Kr3jzolPL/longboi/schematics/longboi-v1.1-schematics.pdf

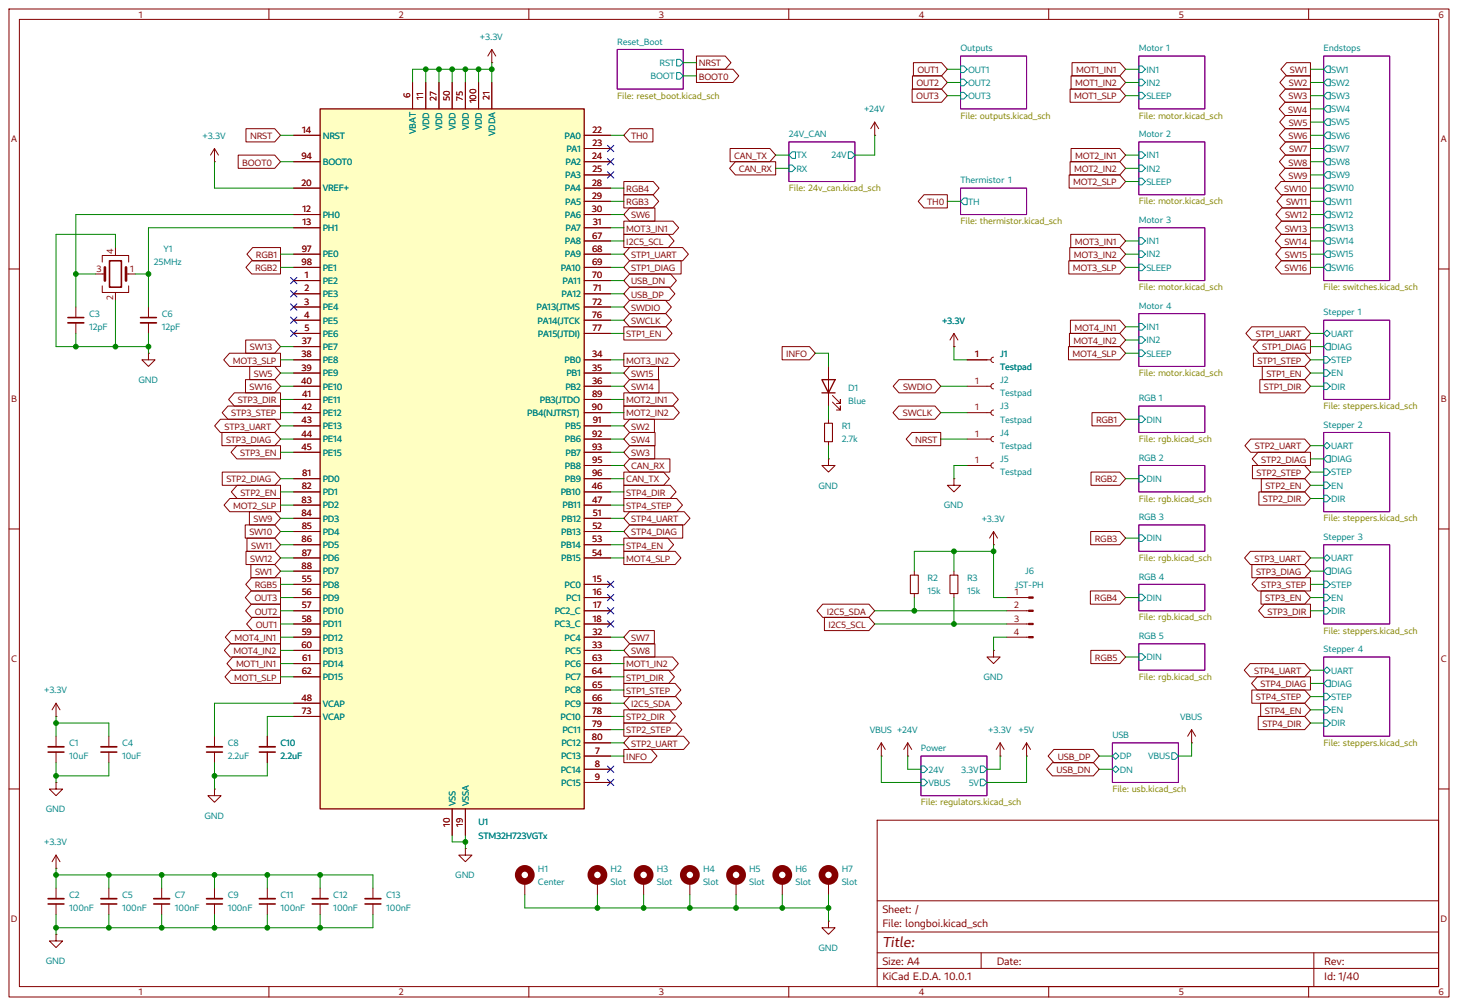
[picture p1: page 1]

IN2 SLEEP Motor 1 File: motor.kicad_sch

IN2 SLEEP Motor 3 File: motor.kicad_sch R2

Stepper 1 File: steppers.kicad_sch UART DIAG

RGB 1 File: rgb.kicad_sch DIN

Stepper 2 File: steppers.kicad_sch DIN

File: rgb.kicad_sch DIN
RGB 5 File: rgb.kicad_sch VBUS DN

VBUS Power File: regulators.kicad_sch

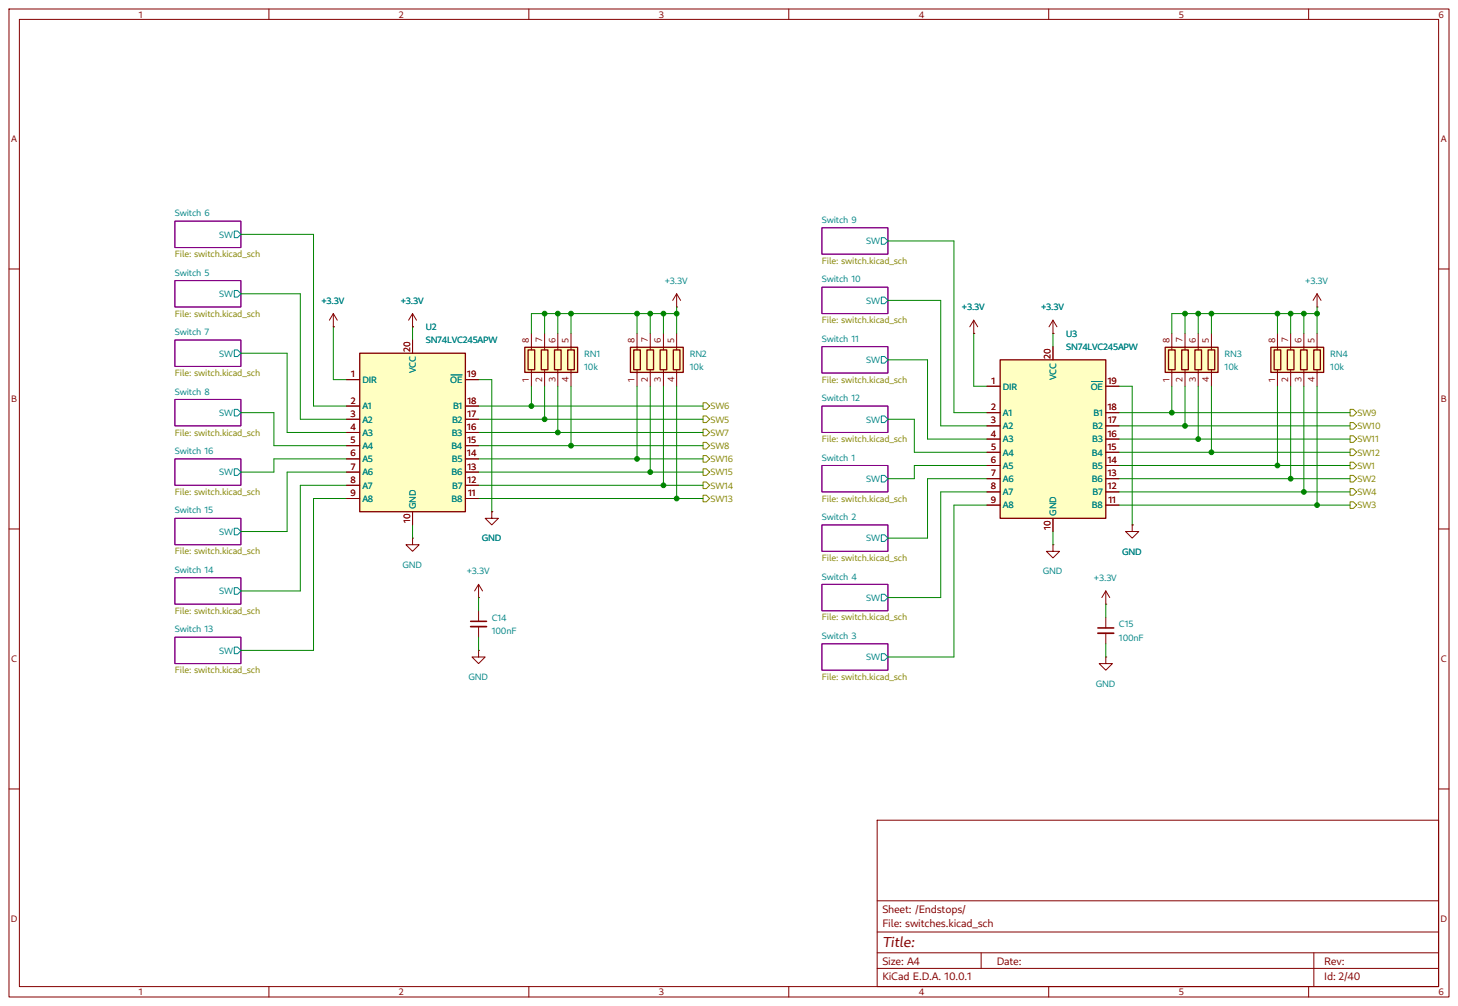
[picture p2: page 2]

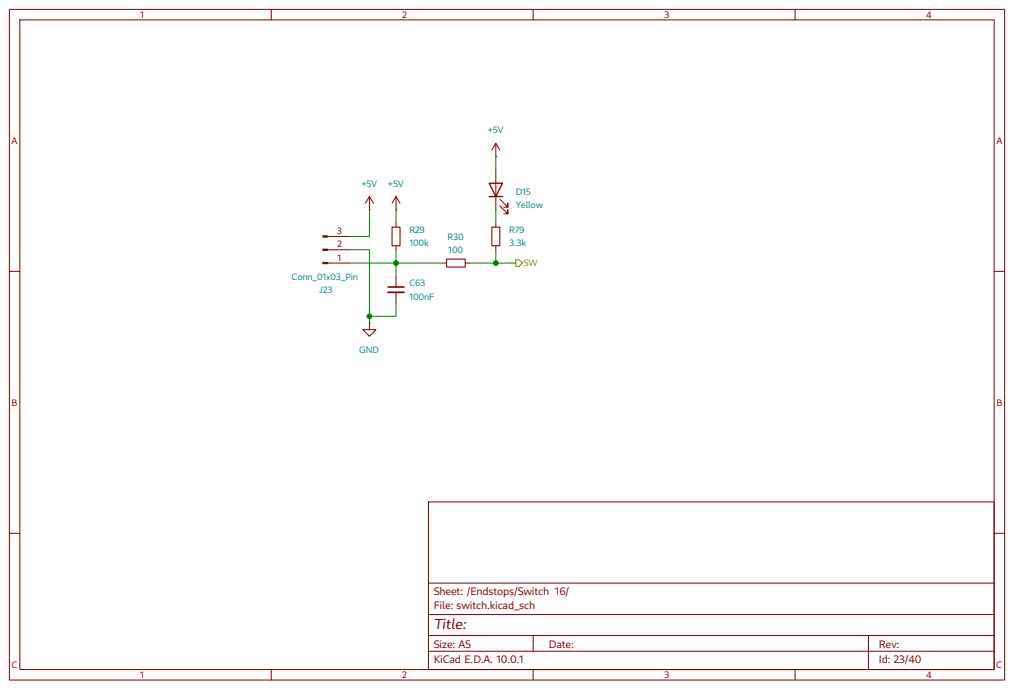
[picture p3: page 3]

Size: A5 | Date: | Rev:
KiCad E.D.A. 10.0.1 | | Id: 23/40

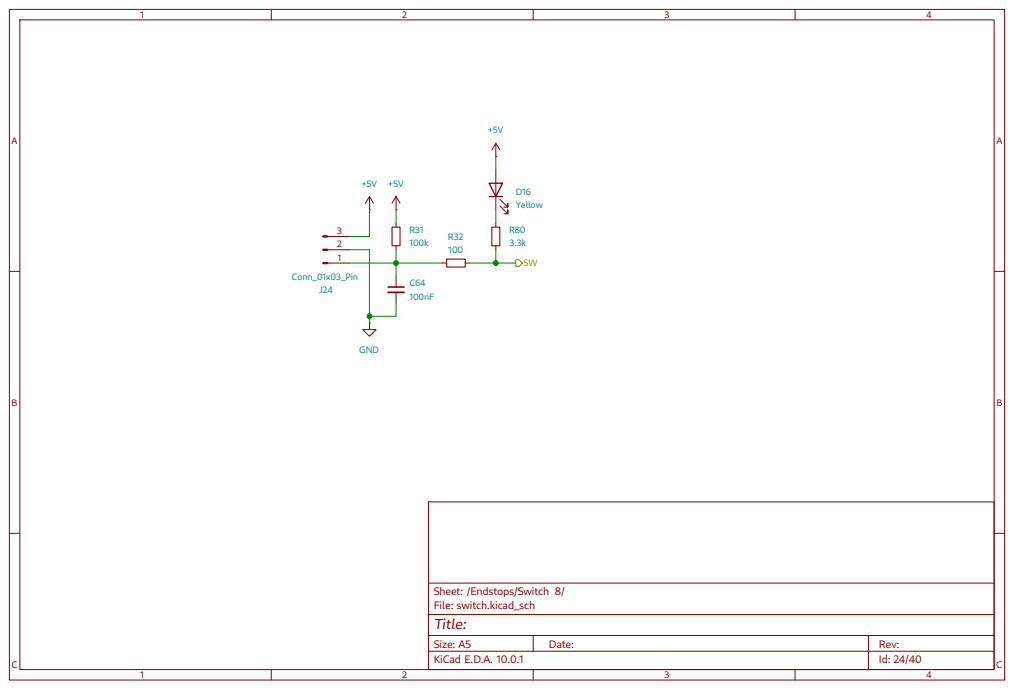
[picture p4: page 4]

Size: A5 | Date: | Rev:
KiCad E.D.A. 10.0.1 | | Id: 24/40

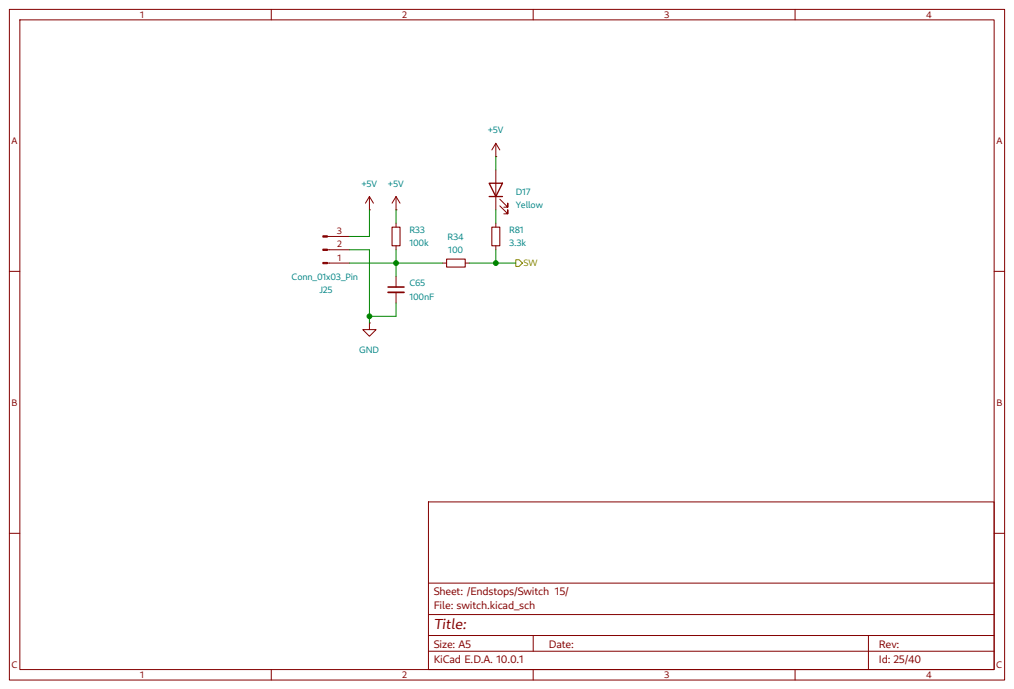
[picture p5: page 5]

Size: A5 | Date: | Rev:
KiCad E.D.A. 10.0.1 | | Id: 25/40

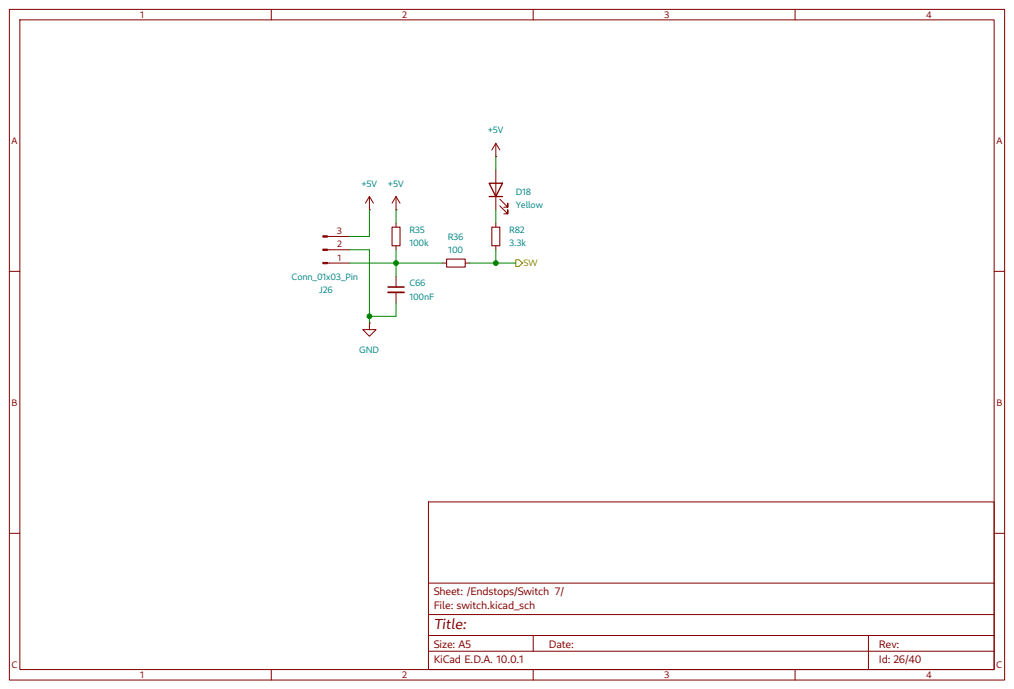
[picture p6: page 6]

Size: A5 | Date: | Rev:
KiCad E.D.A. 10.0.1 | | Id: 26/40

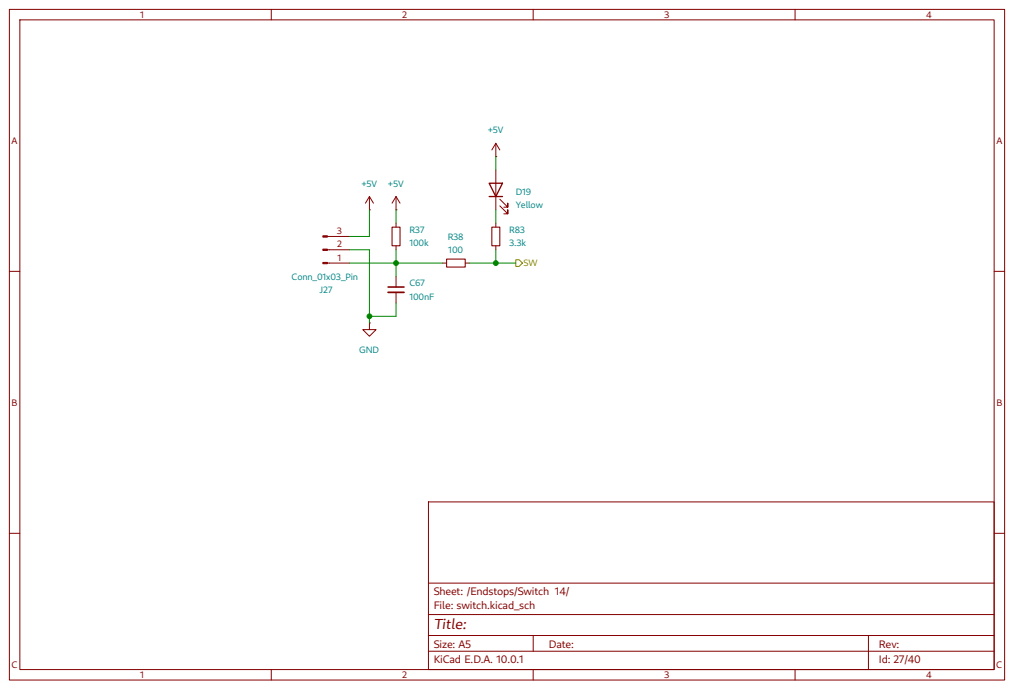
[picture p7: page 7]

Size: A5 | Date: | Rev:
KiCad E.D.A. 10.0.1 | | Id: 27/40

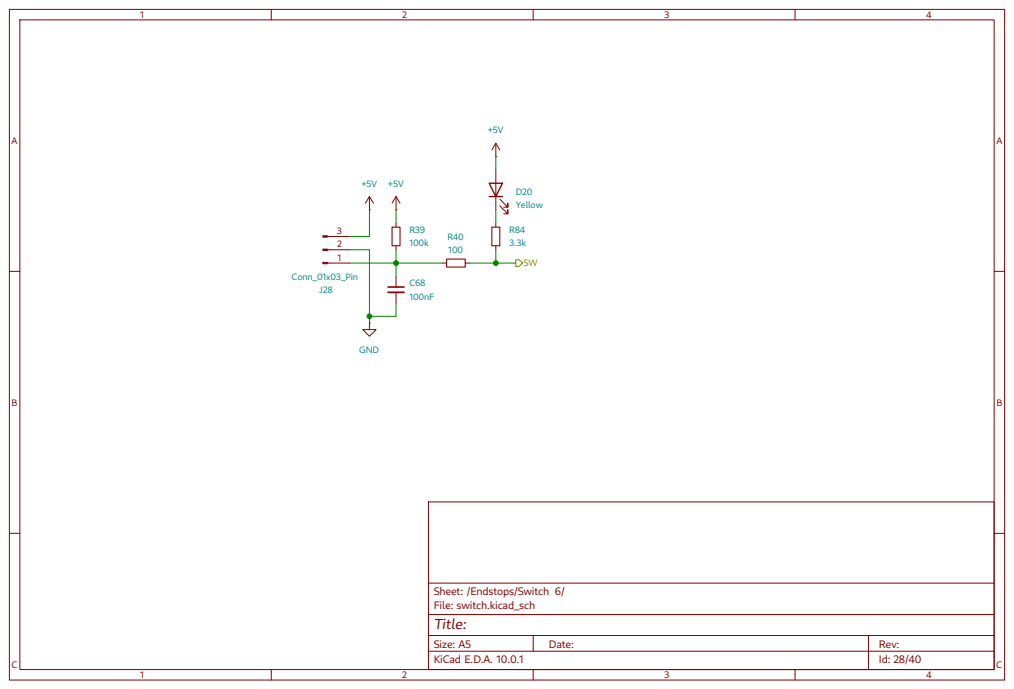
[picture p8: page 8]

Size: A5 | Date: | Rev:
KiCad E.D.A. 10.0.1 | | Id: 28/40

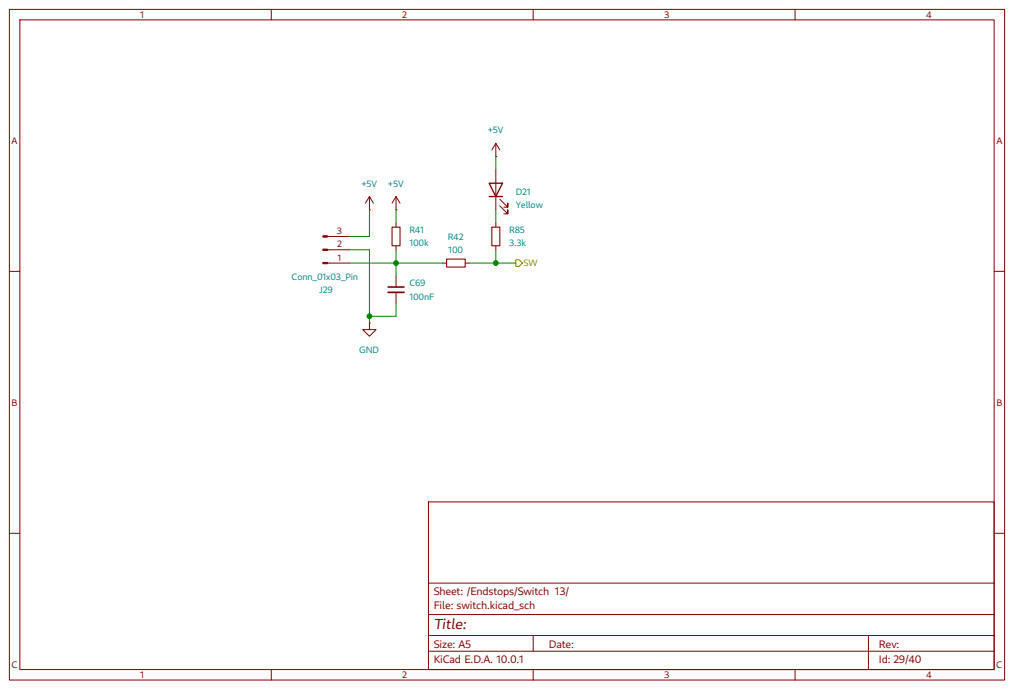
[picture p9: page 9]

Size: A5 | Date: | Rev:
KiCad E.D.A. 10.0.1 | | Id: 29/40

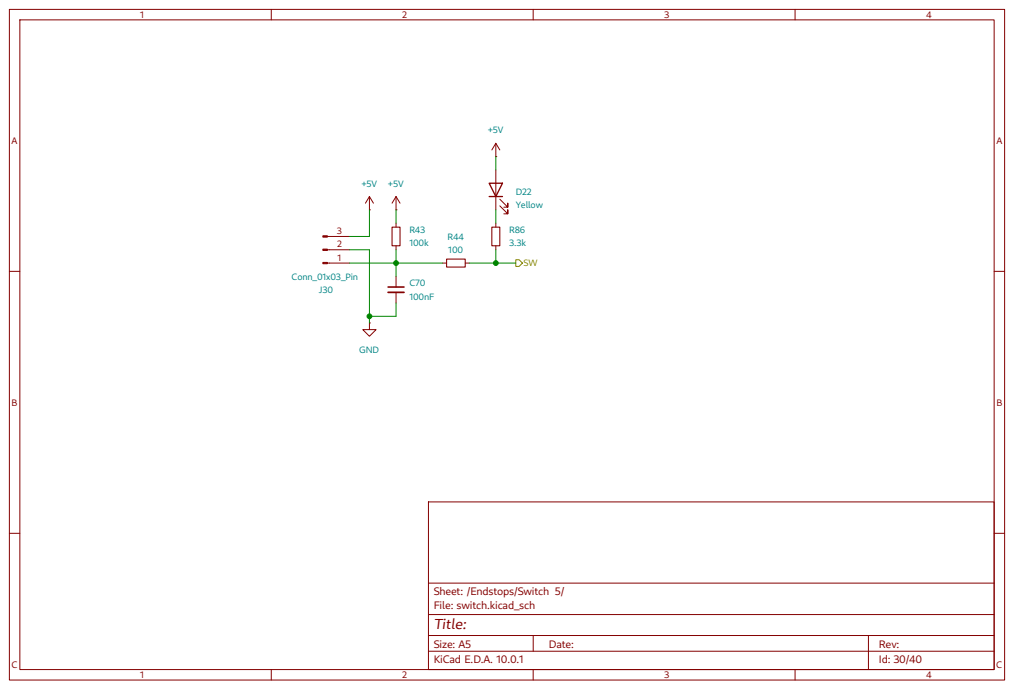
[picture p10: page 10]

Size: A5 | Date: | Rev:
KiCad E.D.A. 10.0.1 | | Id: 30/40

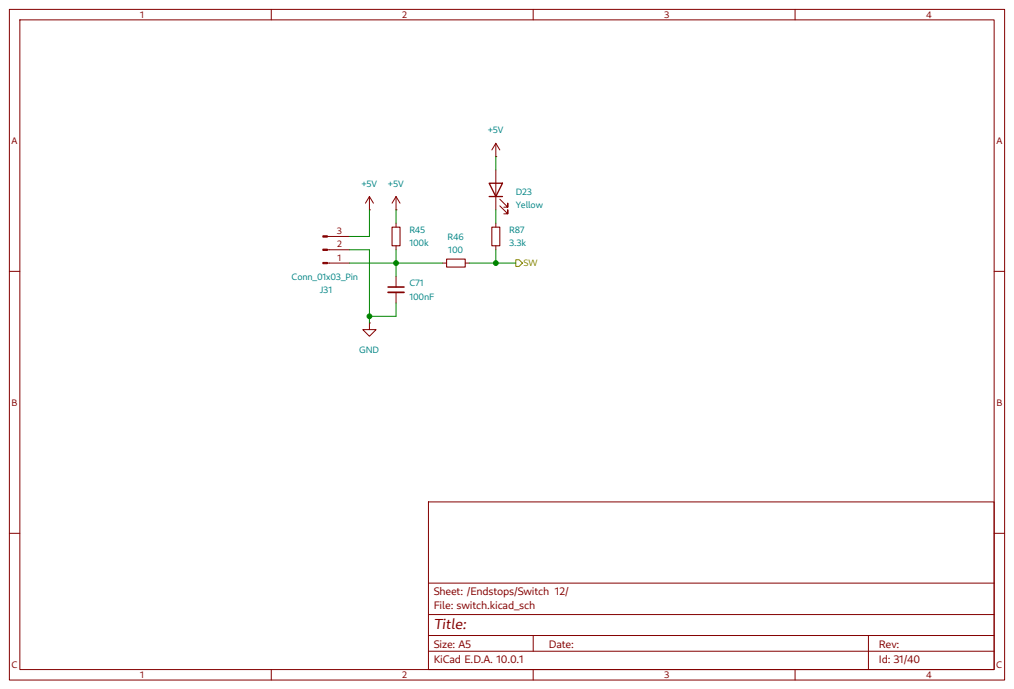
[picture p11: page 11]

Size: A5 | Date: | Rev:
KiCad E.D.A. 10.0.1 | | Id: 31/40

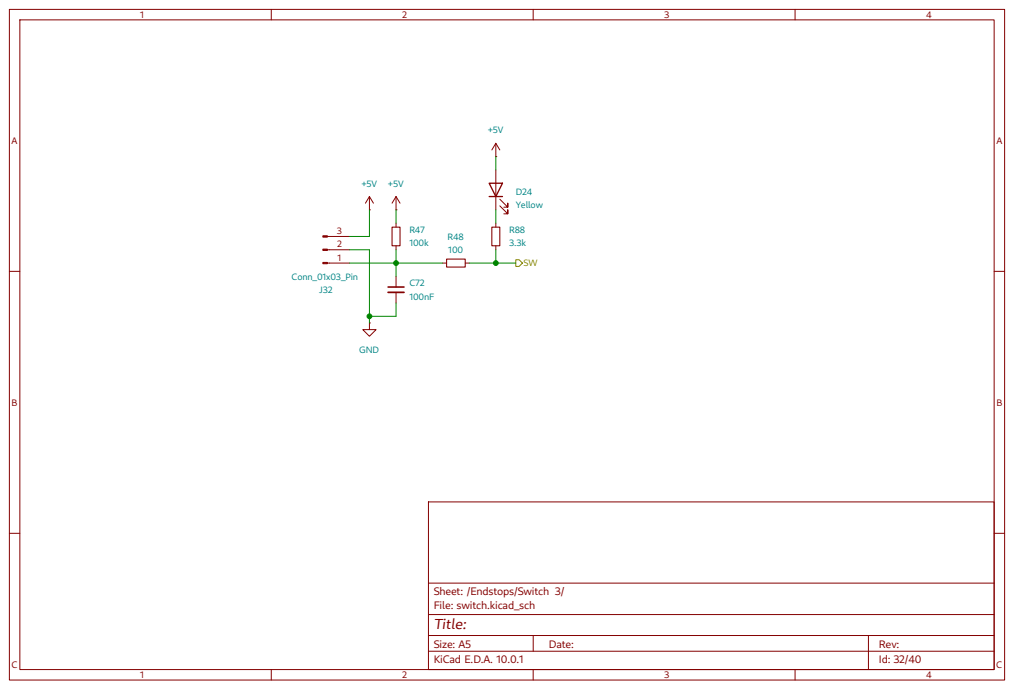
[picture p12: page 12]

Size: A5 | Date: | Rev:
KiCad E.D.A. 10.0.1 | | Id: 32/40

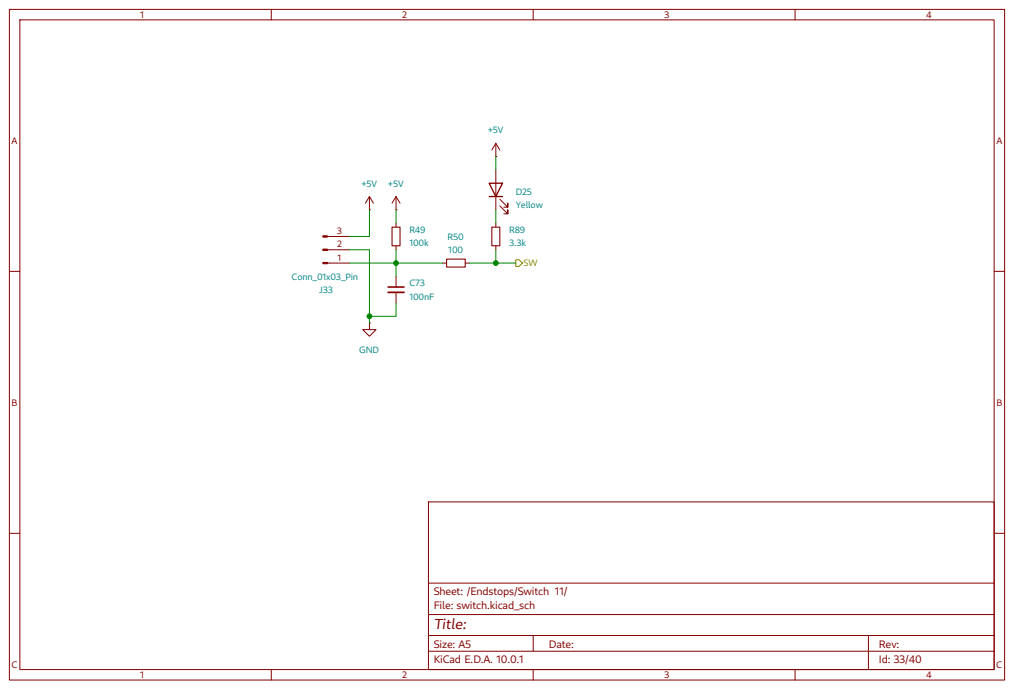
[picture p13: page 13]

Size: A5 | Date: | Rev:
KiCad E.D.A. 10.0.1 | | Id: 33/40

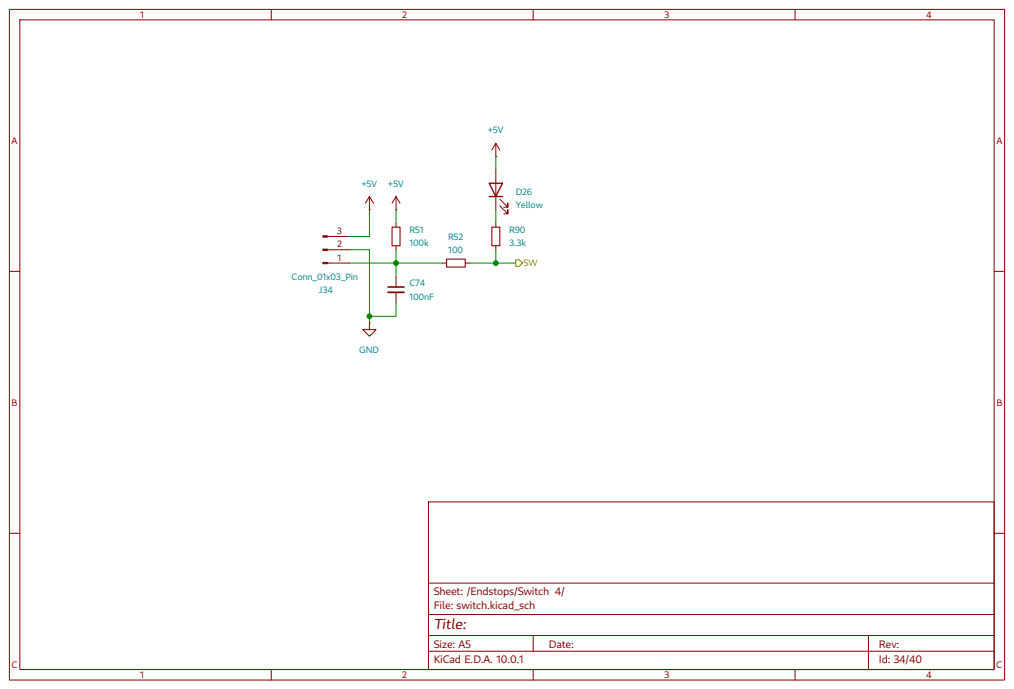
[picture p14: page 14]

Size: A5 | Date: | Rev:
KiCad E.D.A. 10.0.1 | | Id: 34/40

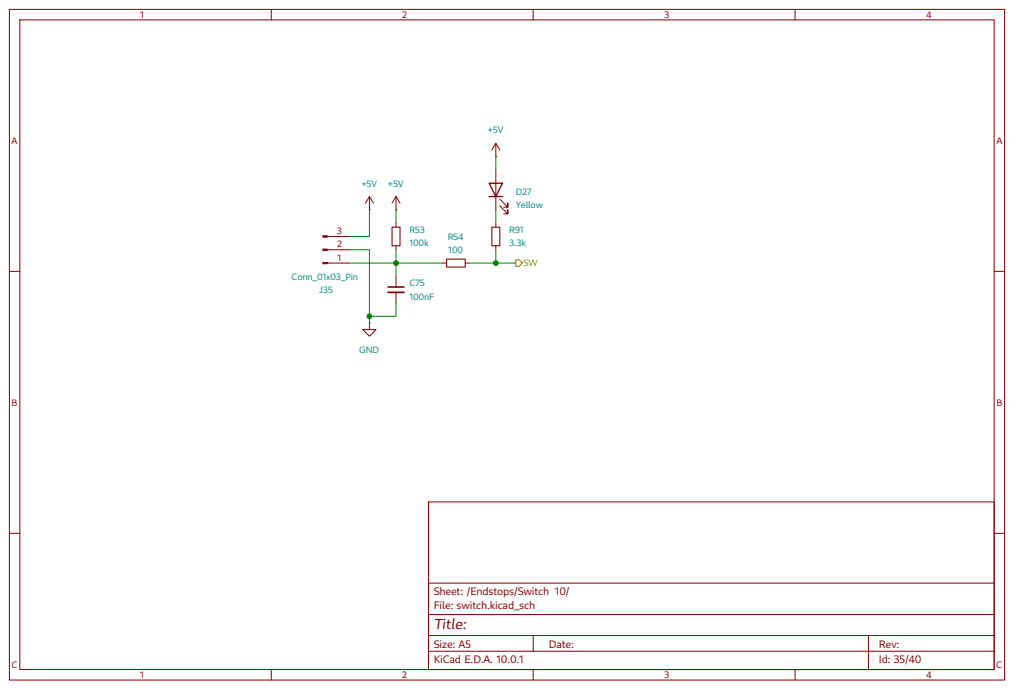
[picture p15: page 15]

Size: A5 | Date: | Rev:
KiCad E.D.A. 10.0.1 | | Id: 35/40

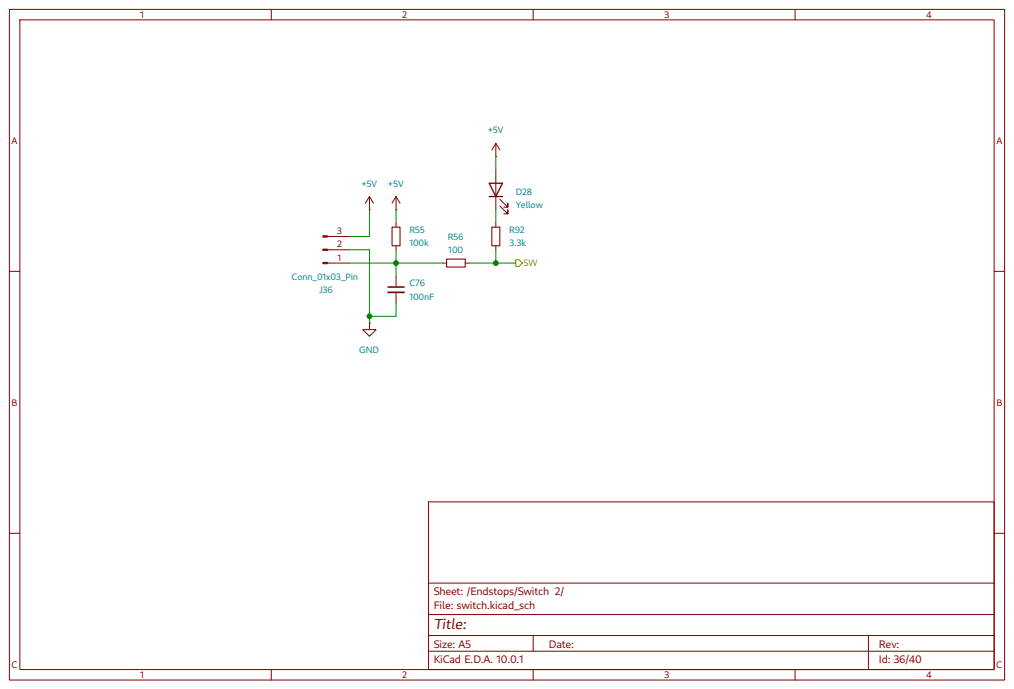
[picture p16: page 16]

Size: A5 | Date: | Rev:
KiCad E.D.A. 10.0.1 | | Id: 36/40

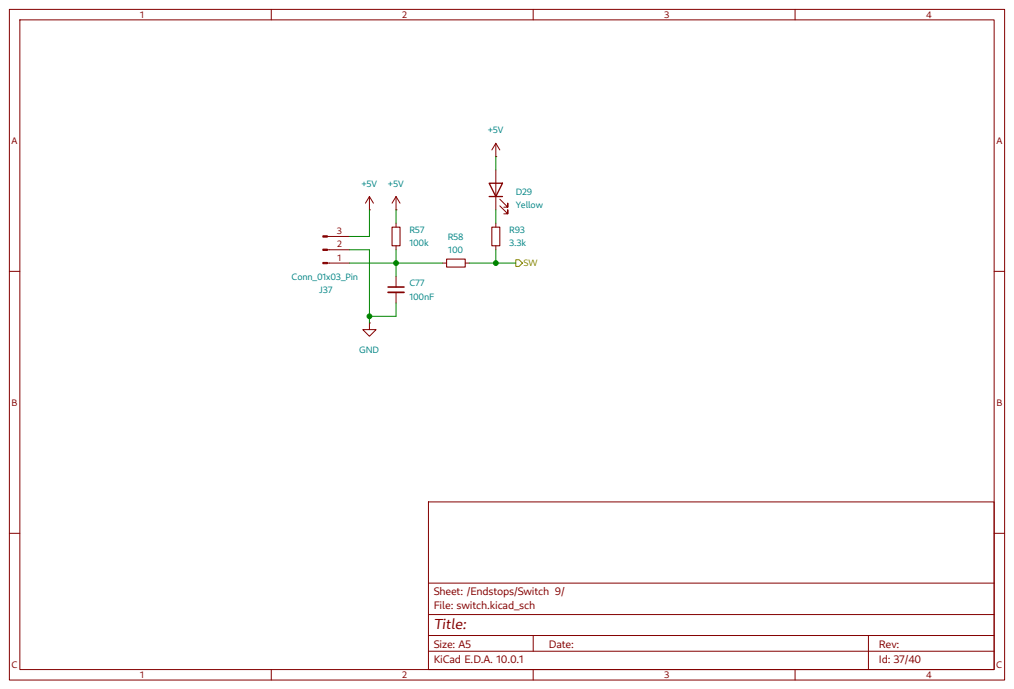
[picture p17: page 17]

Size: A5 | Date: | Rev:
KiCad E.D.A. 10.0.1 | | Id: 37/40

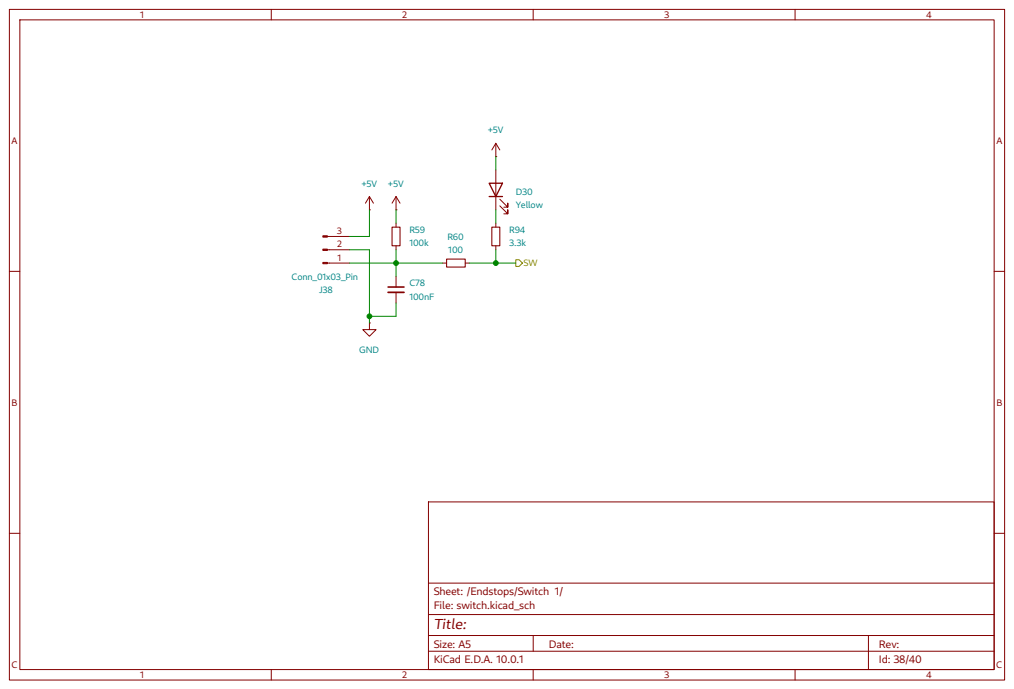
[picture p18: page 18]

Size: A5 | Date: | Rev:
KiCad E.D.A. 10.0.1 | | Id: 38/40

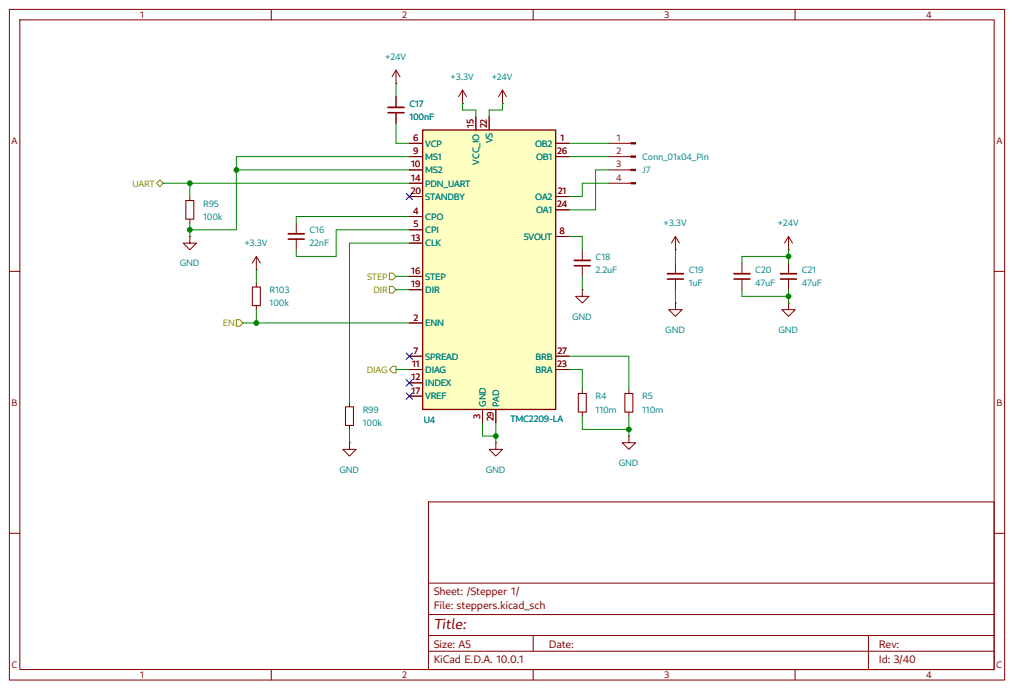
[picture p19: page 19]

Size: A5 | Date: | Rev:
KiCad E.D.A. 10.0.1 | | Id: 3/40

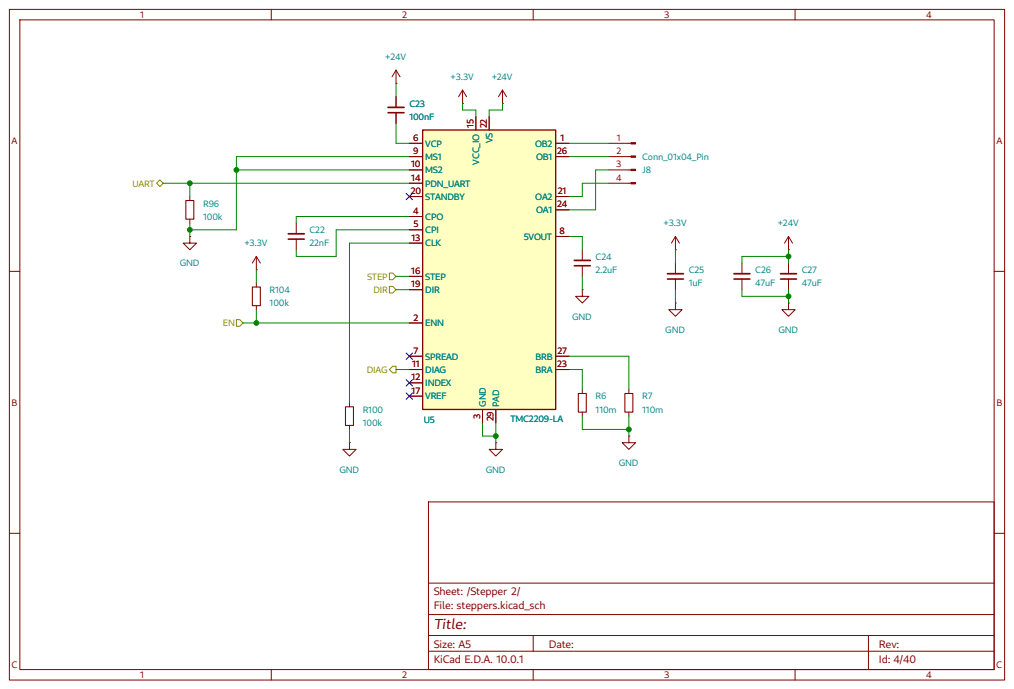
[picture p20: page 20]

Size: A5 | Date: | Rev:
KiCad E.D.A. 10.0.1 | | Id: 4/40

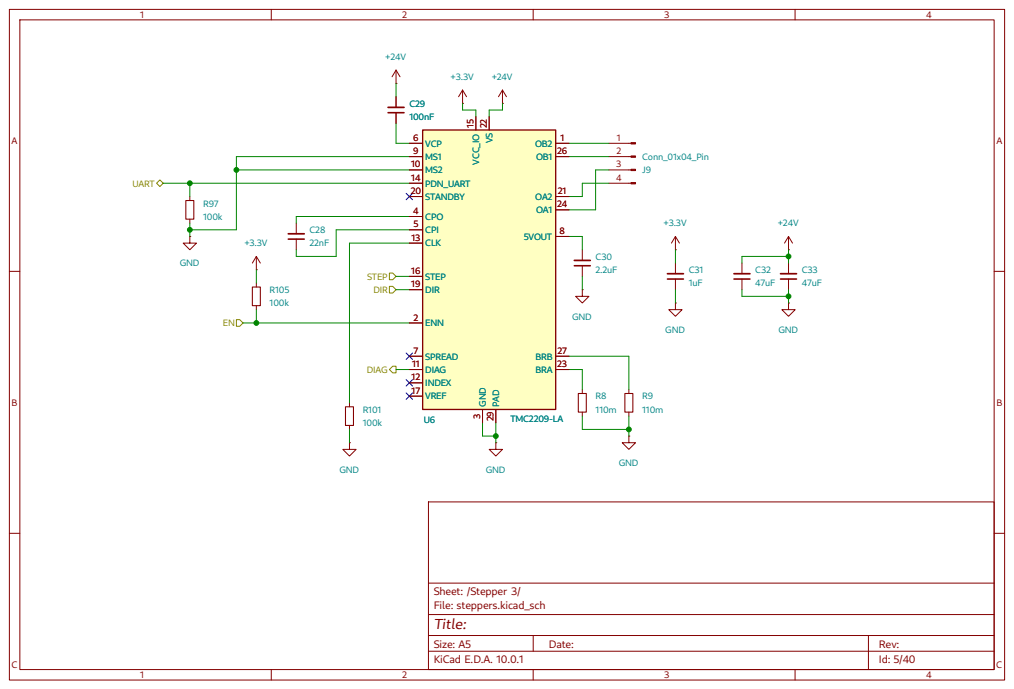
[picture p21: page 21]

Size: A5 | Date: | Rev:
KiCad E.D.A. 10.0.1 | | Id: 5/40

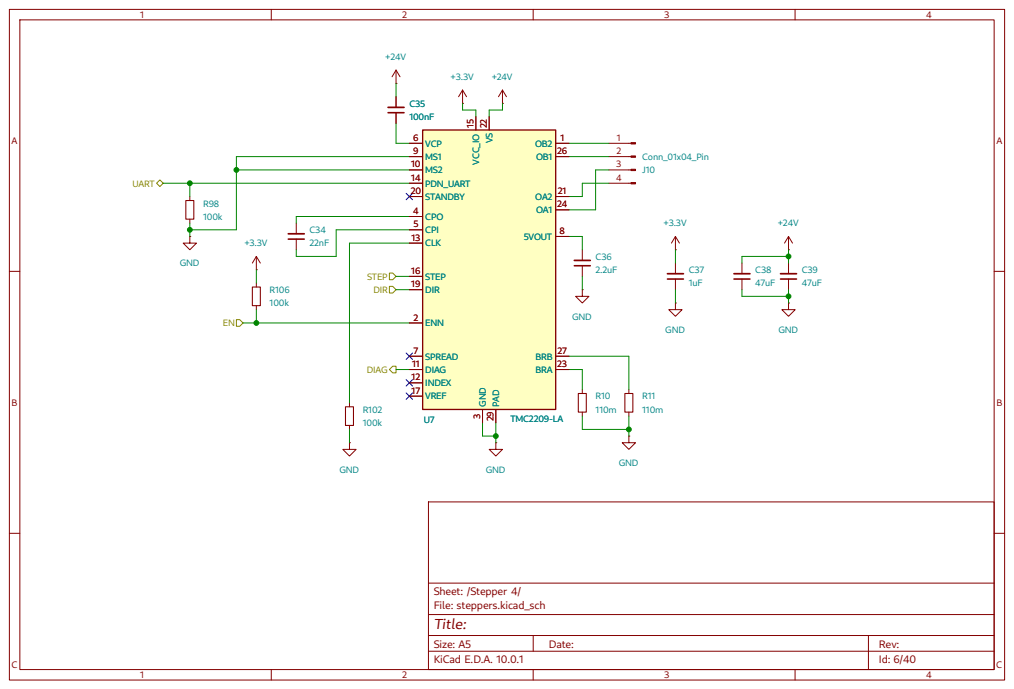
[picture p22: page 22]

Size: A5 | Date: | Rev:
KiCad E.D.A. 10.0.1 | | Id: 6/40

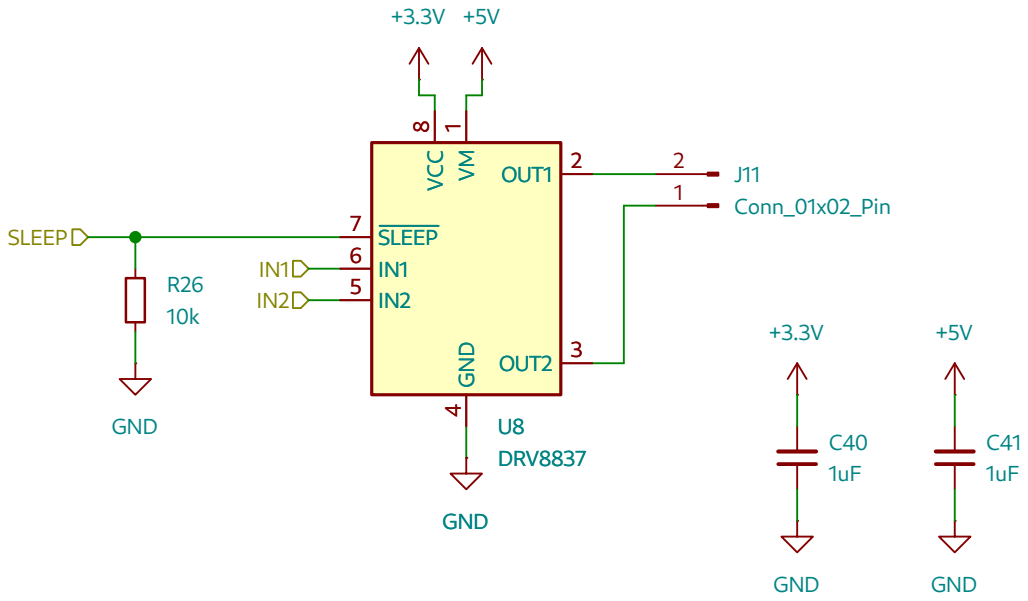
[picture p23: page 23]

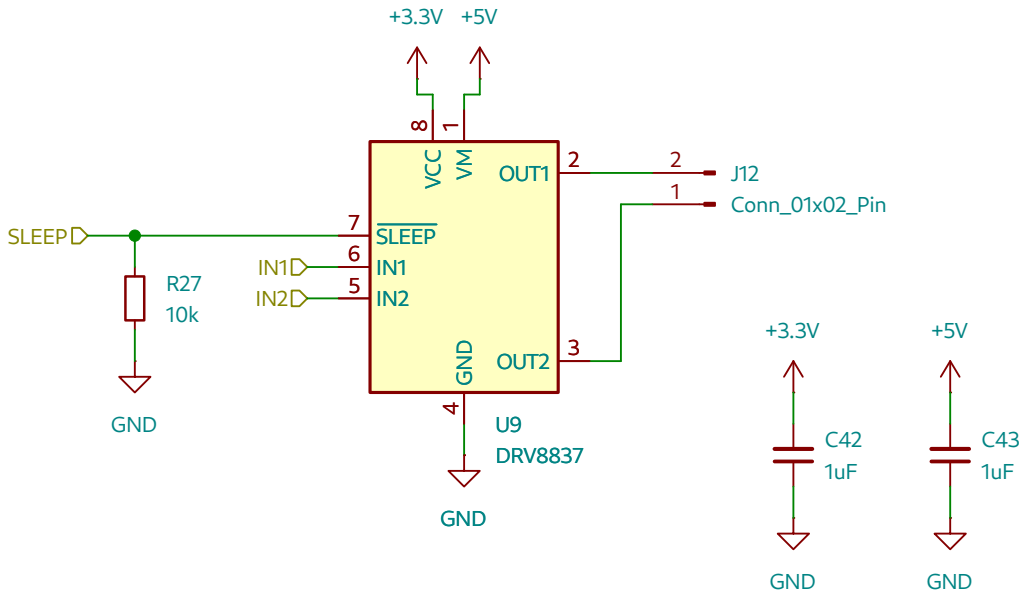
[picture p24: page 24]

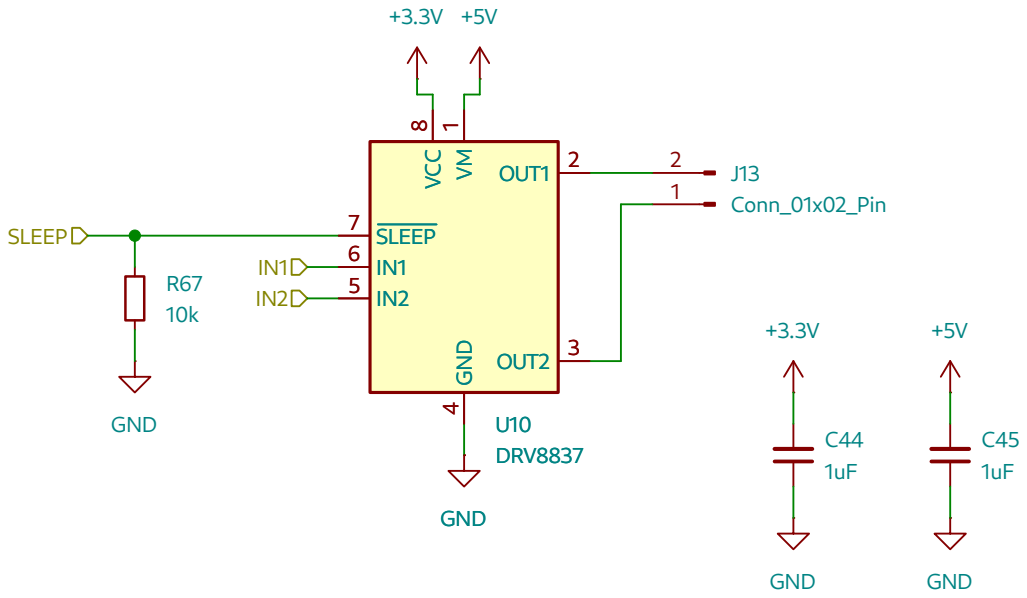
[picture p25: page 25]

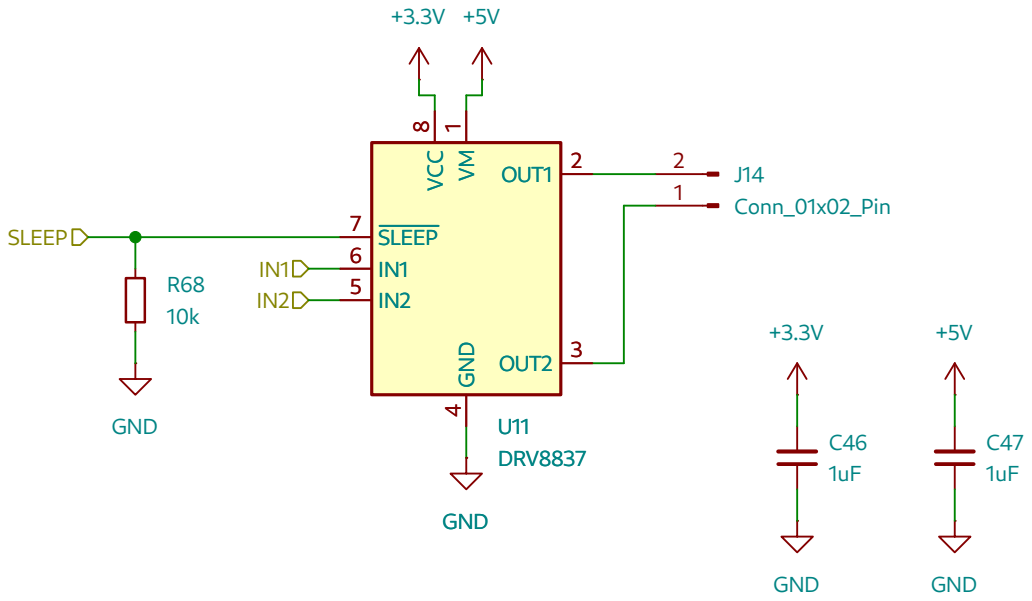
[picture p26: page 26]

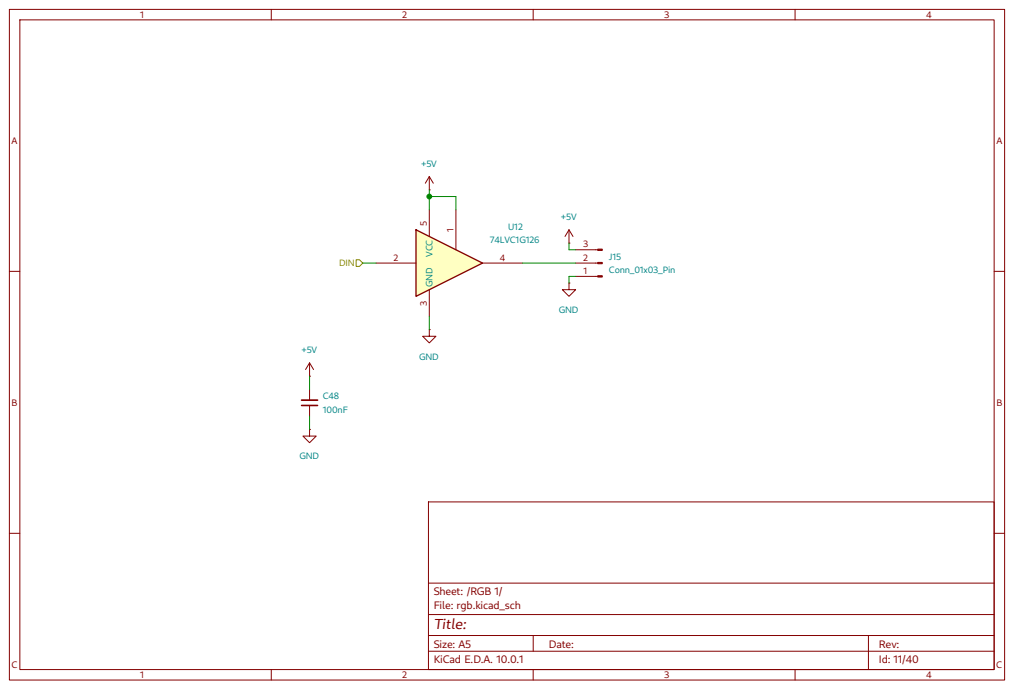
[picture p27: page 27]

Size: A5 | Date: | Rev:
KiCad E.D.A. 10.0.1 | | Id: 11/40

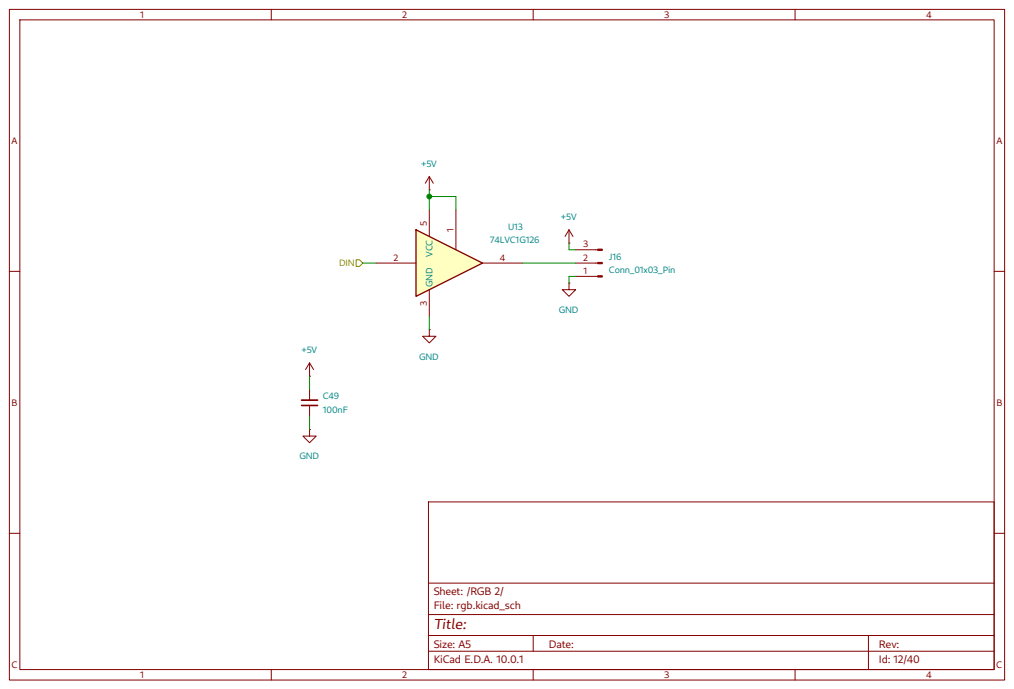
[picture p28: page 28]

Size: A5 | Date: | Rev:
KiCad E.D.A. 10.0.1 | | Id: 12/40

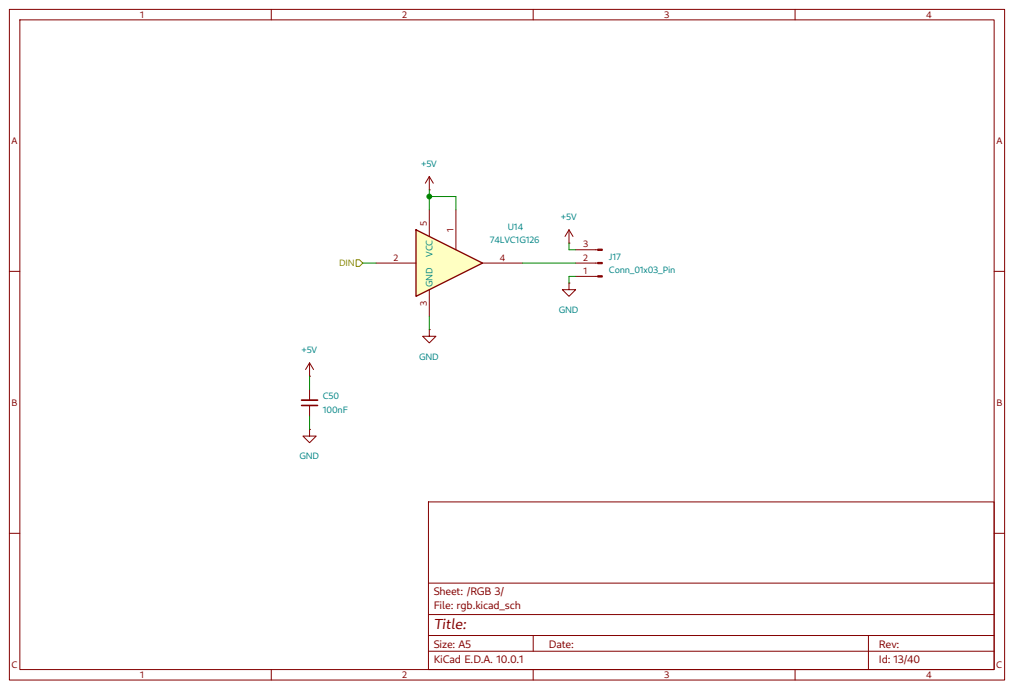
[picture p29: page 29]

Size: A5 | Date: | Rev:
KiCad E.D.A. 10.0.1 | | Id: 13/40

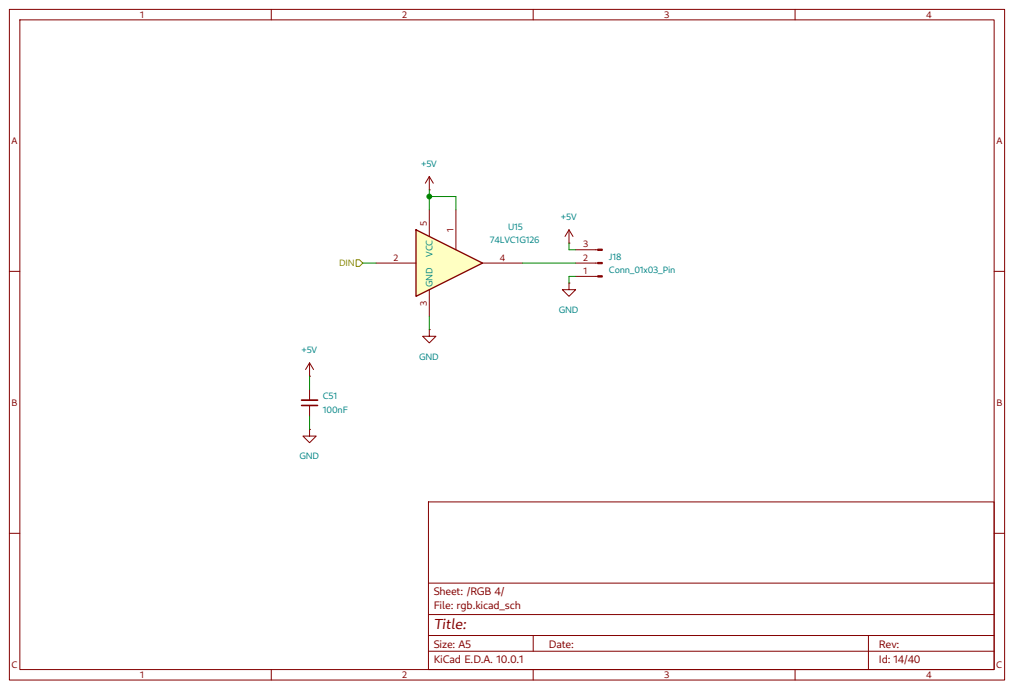
[picture p30: page 30]

Size: A5 | Date: | Rev:
KiCad E.D.A. 10.0.1 | | Id: 14/40

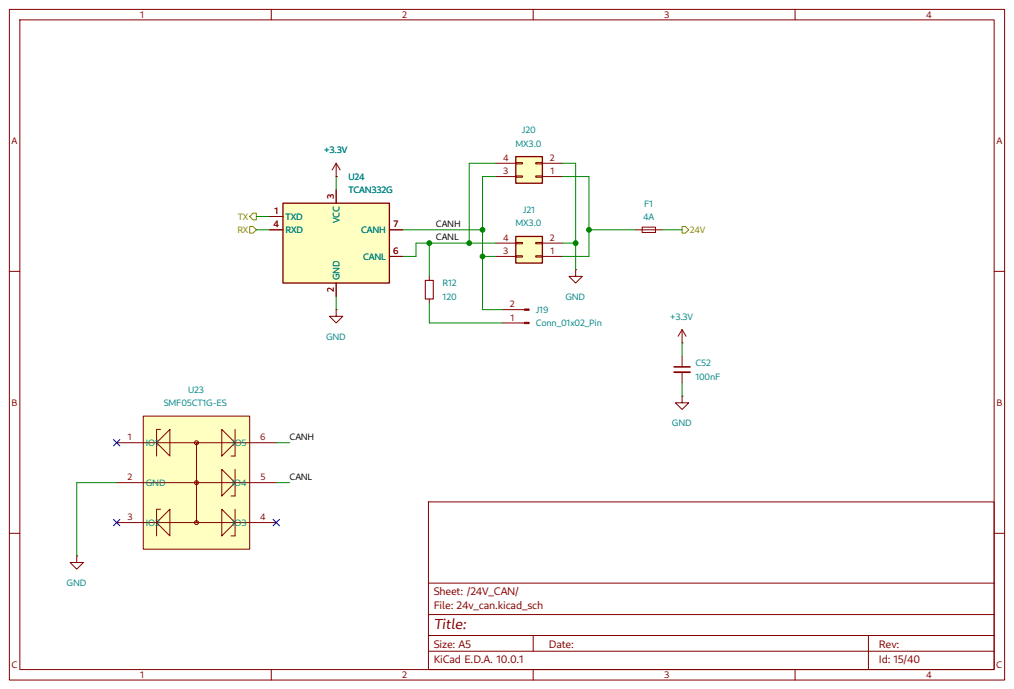
[picture p31: page 31]

Size: A5 | Date: | Rev:
KiCad E.D.A. 10.0.1 | | Id: 15/40

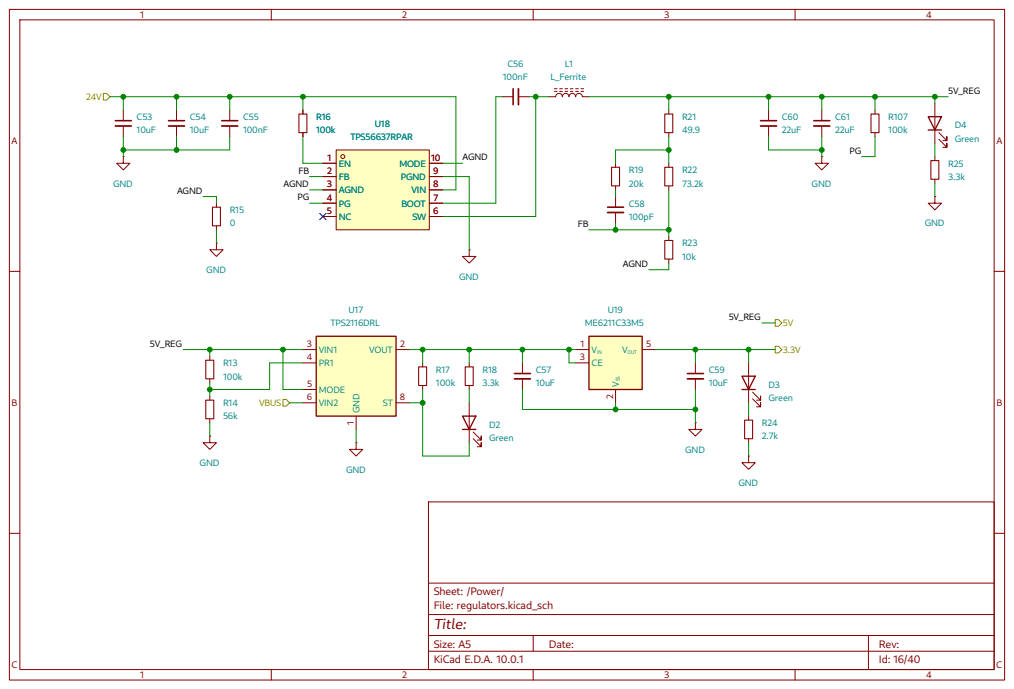
[picture p32: page 32]

Size: A5 | Date: | Rev:
KiCad E.D.A. 10.0.1 | | Id: 16/40

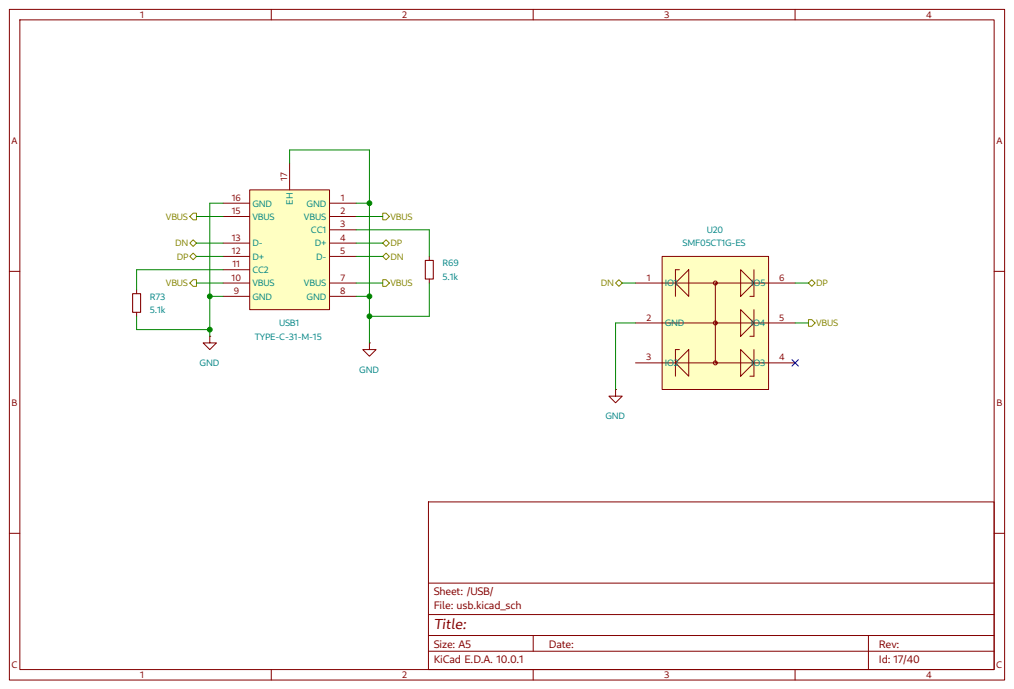
[picture p33: page 33]

Size: A5 | Date: | Rev:
KiCad E.D.A. 10.0.1 | | Id: 17/40

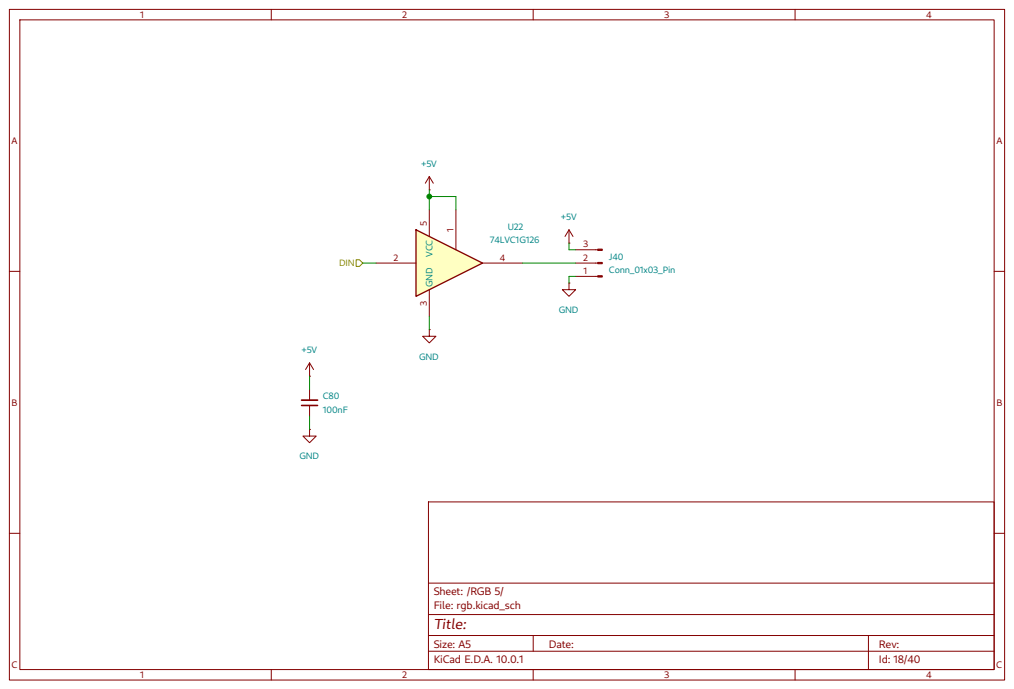
[picture p34: page 34]

Size: A5 | Date: | Rev:
KiCad E.D.A. 10.0.1 | | Id: 18/40

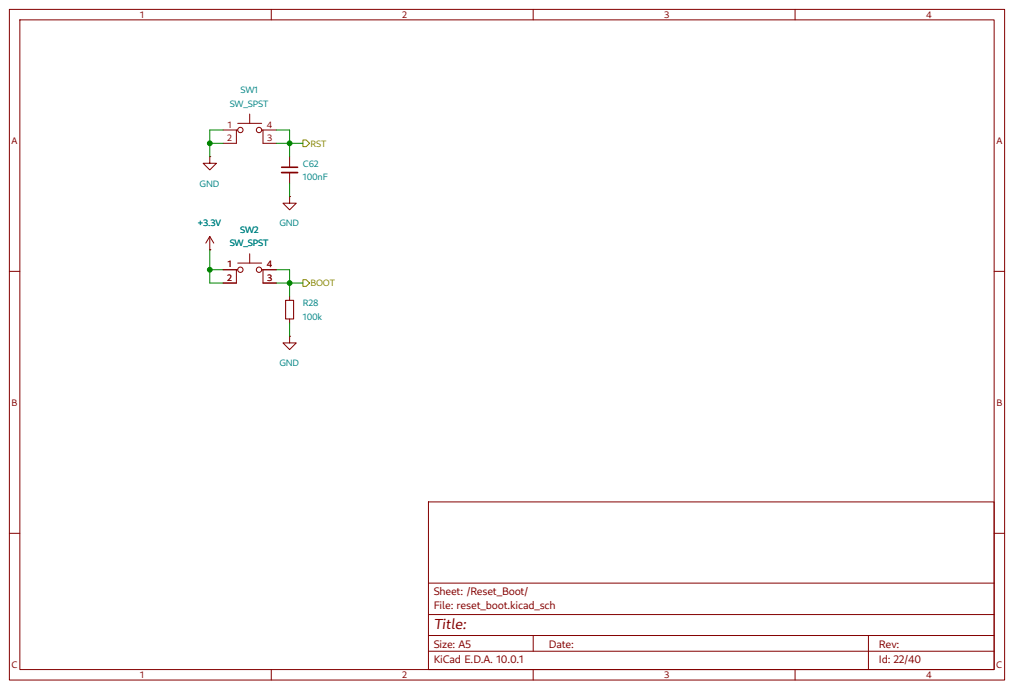
[picture p35: page 35]

Size: A5 | Date: | Rev:
KiCad E.D.A. 10.0.1 | | Id: 22/40

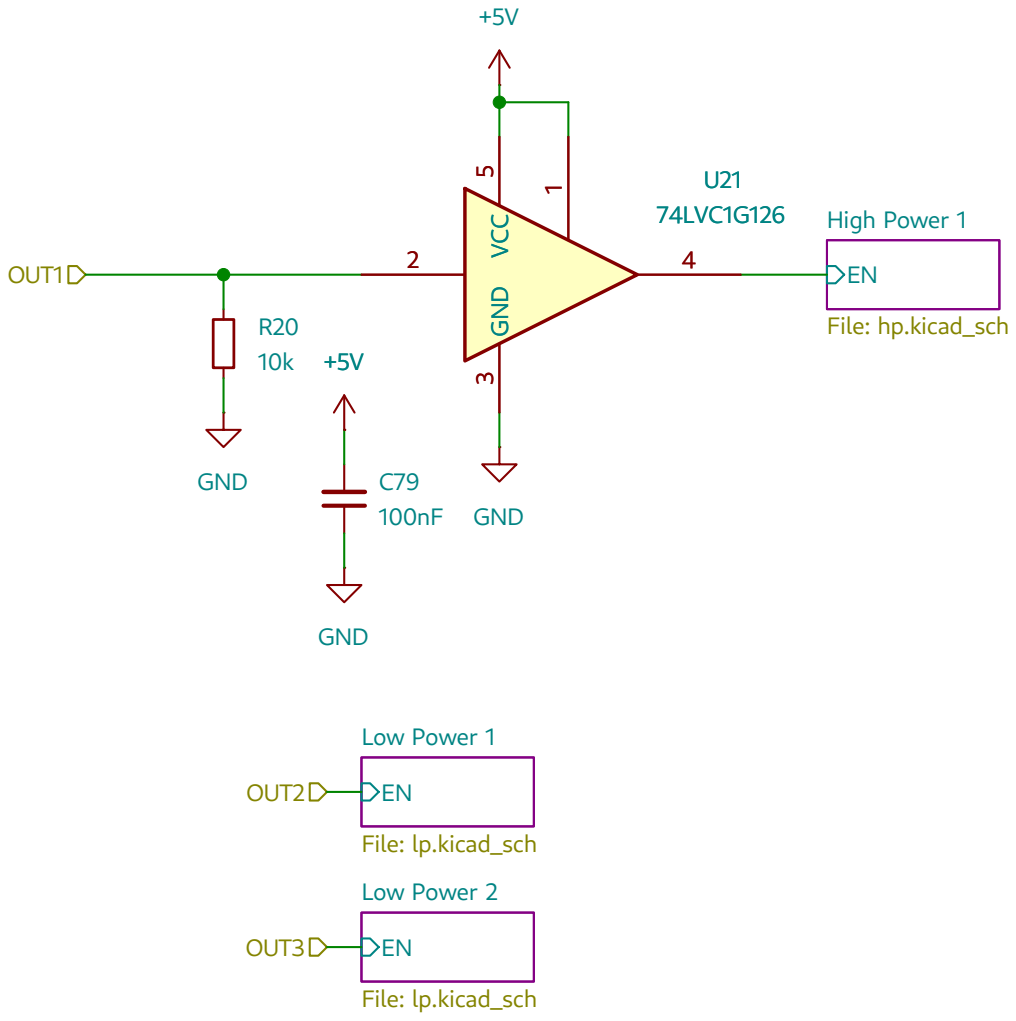
[picture p36: page 36]

High Power 1 File: hp.kicad_sch +5V GND

Low Power 2 File: lp.kicad_sch EN

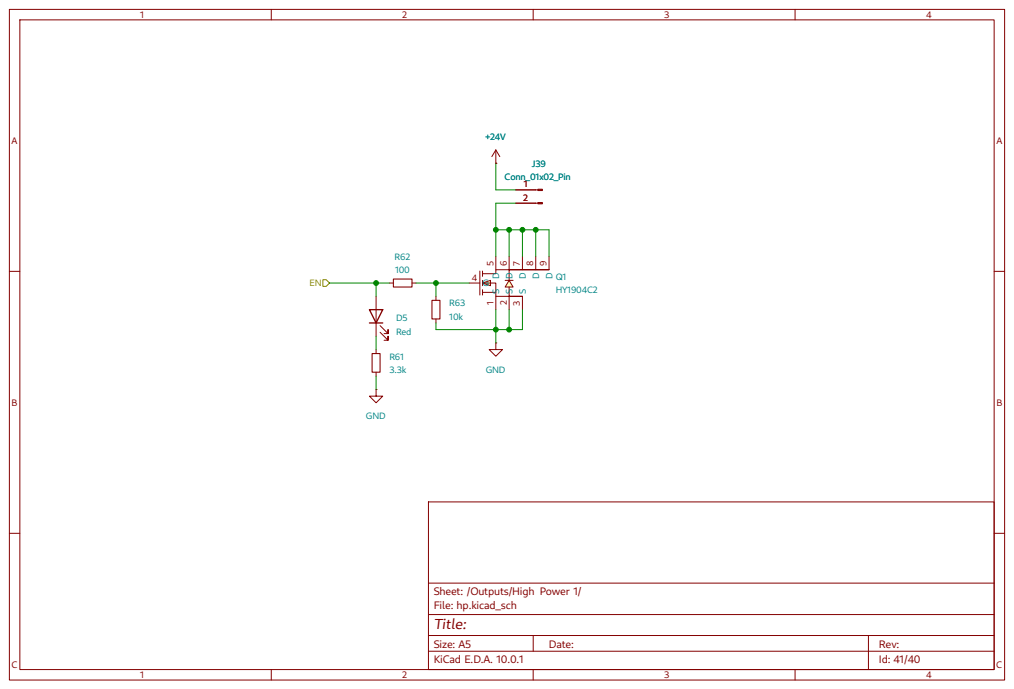
[picture p37: page 37]

Sheet: /Outputs/High Power 1/
File: hp.kicad_sch
Title:

Size: A5 | Date: | Rev:
KiCad E.D.A. 10.0.1 | | Id: 41/40

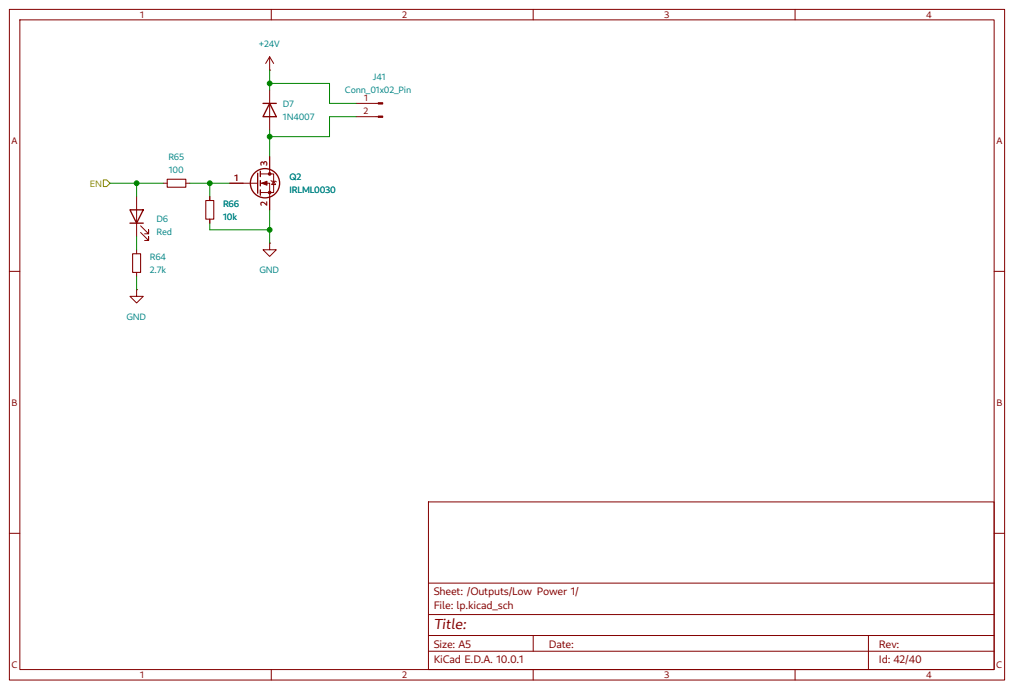
[picture p38: page 38]

Sheet: /Outputs/Low Power 1/
File: lp.kicad_sch
Title:

Size: A5 | Date: | Rev:
KiCad E.D.A. 10.0.1 | | Id: 42/40

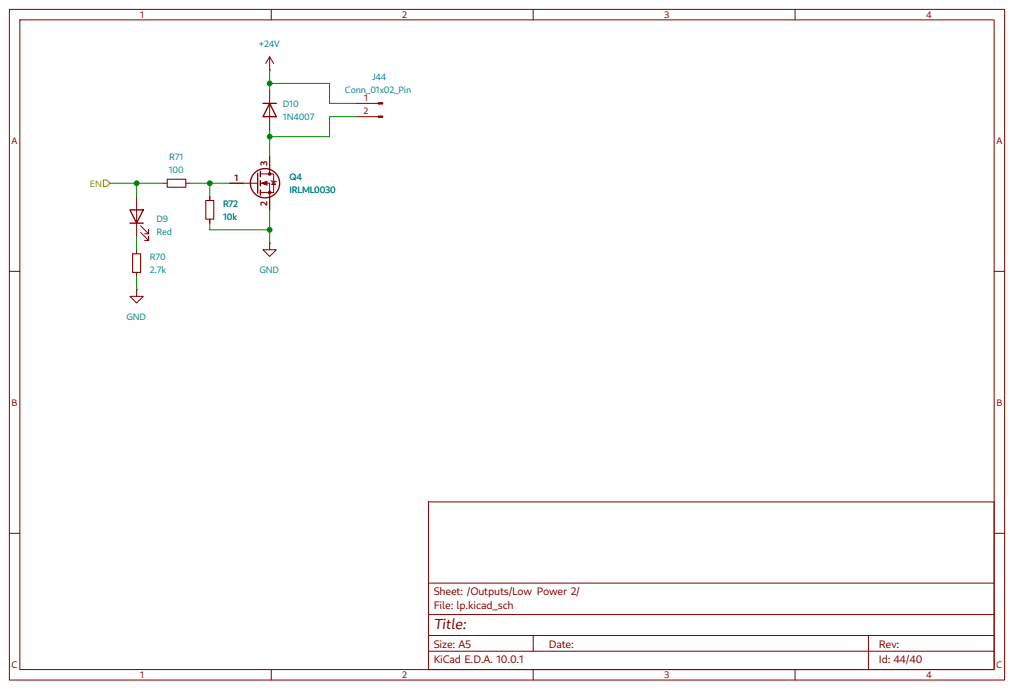
[picture p39: page 39]

Sheet: /Outputs/Low Power 2/
File: lp.kicad_sch
Title:

Size: A5 | Date: | Rev:
KiCad E.D.A. 10.0.1 | | Id: 44/40

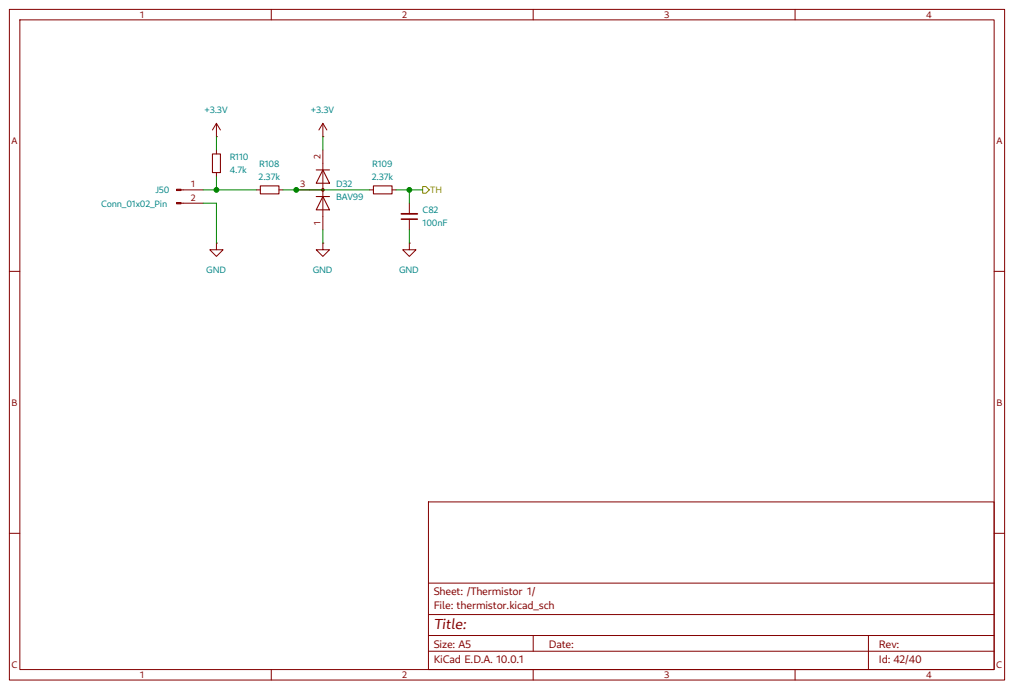
[picture p40: page 40]

Size: A5 | Date: | Rev:
KiCad E.D.A. 10.0.1 | | Id: 42/40
