Kr3jzolPL/longboi/pcb/24v_can.kicad_sch

## KiCad design pcb/24v_can.kicad_sch (2026-05-06)

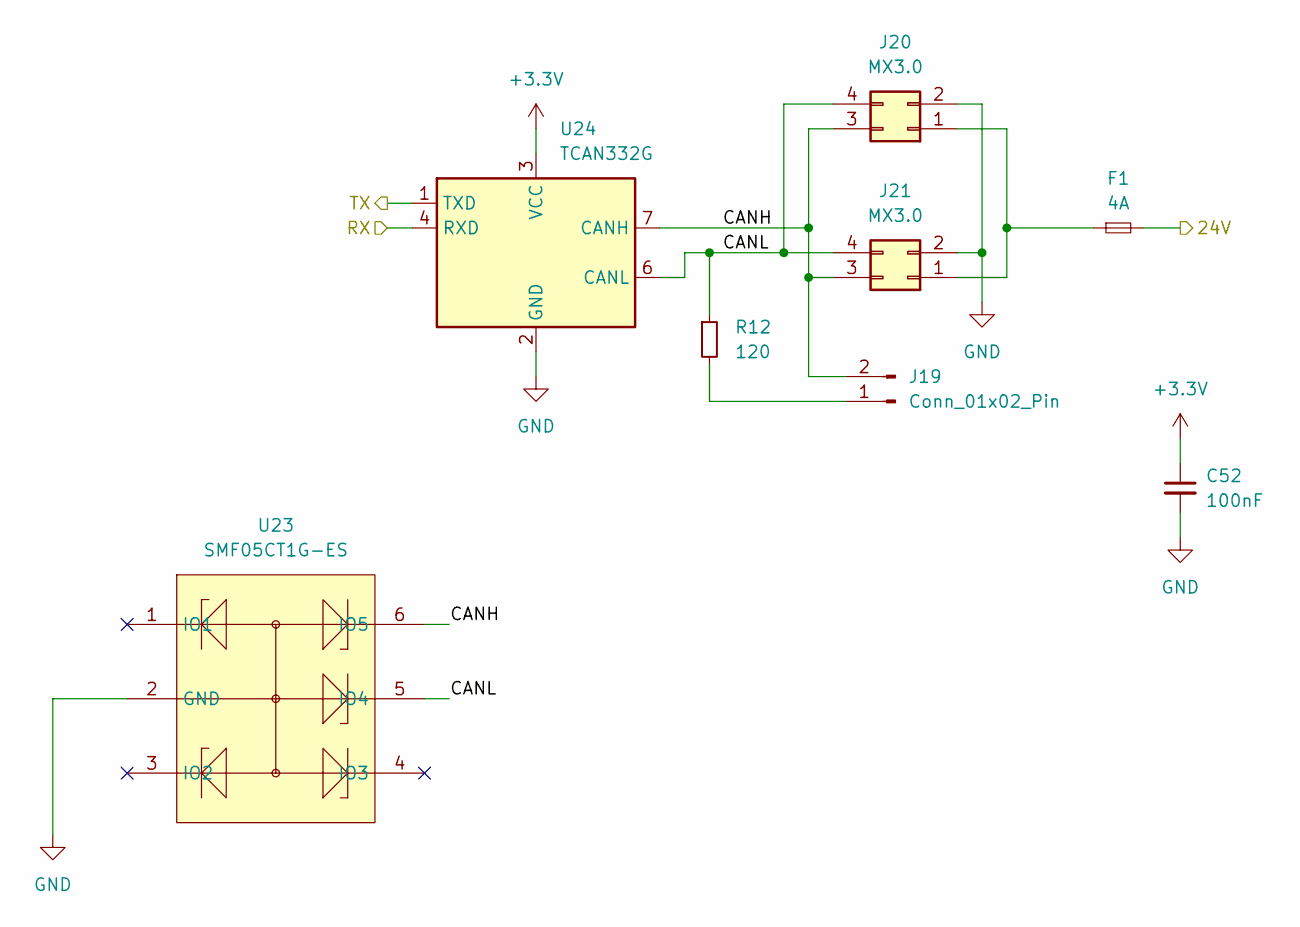
[picture p41: schematic 24v_can.kicad_sch]

Parts:
C52: 100nF; C_0603_1608Metric; LCSC C14663
F1: 4A; Fuseholder_Littelfuse_Nano2_154x; LCSC C108518
J19: Conn_01x02_Pin; PinHeader_1x02_P2.54mm_Vertical; LCSC C492401
J20, J21: MX3.0; Molex_Micro-Fit_3.0_43045-0412_2x02_P3.00mm_Vertical; LCSC C277721
R12: 120; R_0603_1608Metric; LCSC C22787
U23: SMF05CT1G-ES; SOT-363_SC-70-6; LCSC Part C5180312
U24: TCAN332G; SOIC-8_3.9x4.9mm_P1.27mm; LCSC C191010

Connections:
24V: F1.2
+3.3V: C52.1, U24.3 (VCC)
CANH: J19.2, J20.3, J21.3, U23.6 (IO5), U24.7 (CANH)
CANL: J20.4, J21.4, R12.1, U23.5 (IO4), U24.6 (CANL)
GND: C52.2, J20.2, J21.2, U23.2 (GND), U24.2 (GND)
unnamed: F1.1, J20.1, J21.1
unnamed: J19.1, R12.2
RX: U24.4 (RXD)
TX: U24.1 (TXD)
