Kr3jzolPL/longboi/pcb/hp.kicad_sch

## KiCad design pcb/hp.kicad_sch (2026-05-06)

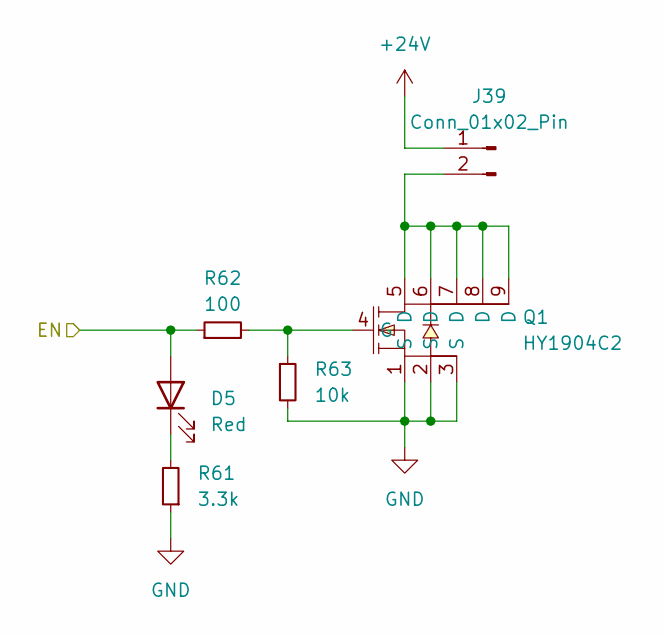
[picture p42: schematic hp.kicad_sch]

Parts:
D5: Red; LED_0603_1608Metric; LCSC C965799
J39: Conn_01x02_Pin; Molex_Micro-Fit_3.0_43045-0212_2x01_P3.00mm_Vertical; LCSC C293362
Q1: HY1904C2; DFN-8_L5.9-W5.2-P1.27-LS6.2-BL; LCSC Part C358116
R61: 3.3k; R_0603_1608Metric; LCSC C22978
R62: 100; R_0603_1608Metric; LCSC C105588
R63: 10k; R_0603_1608Metric; LCSC C98220

Connections:
+24V: J39.1
EN: D5.2 (A), R62.1
GND: Q1.1 (S), Q1.2 (S), Q1.3 (S), R61.1, R63.2
unnamed: D5.1 (K), R61.2
unnamed: J39.2, Q1.5 (D), Q1.6 (D), Q1.7 (D), Q1.8 (D), Q1.9 (D)
unnamed: Q1.4 (G), R62.2, R63.1
