Kr3jzolPL/longboi/pcb/longboi.kicad_sch

## KiCad design pcb/longboi.kicad_sch (2026-05-06)

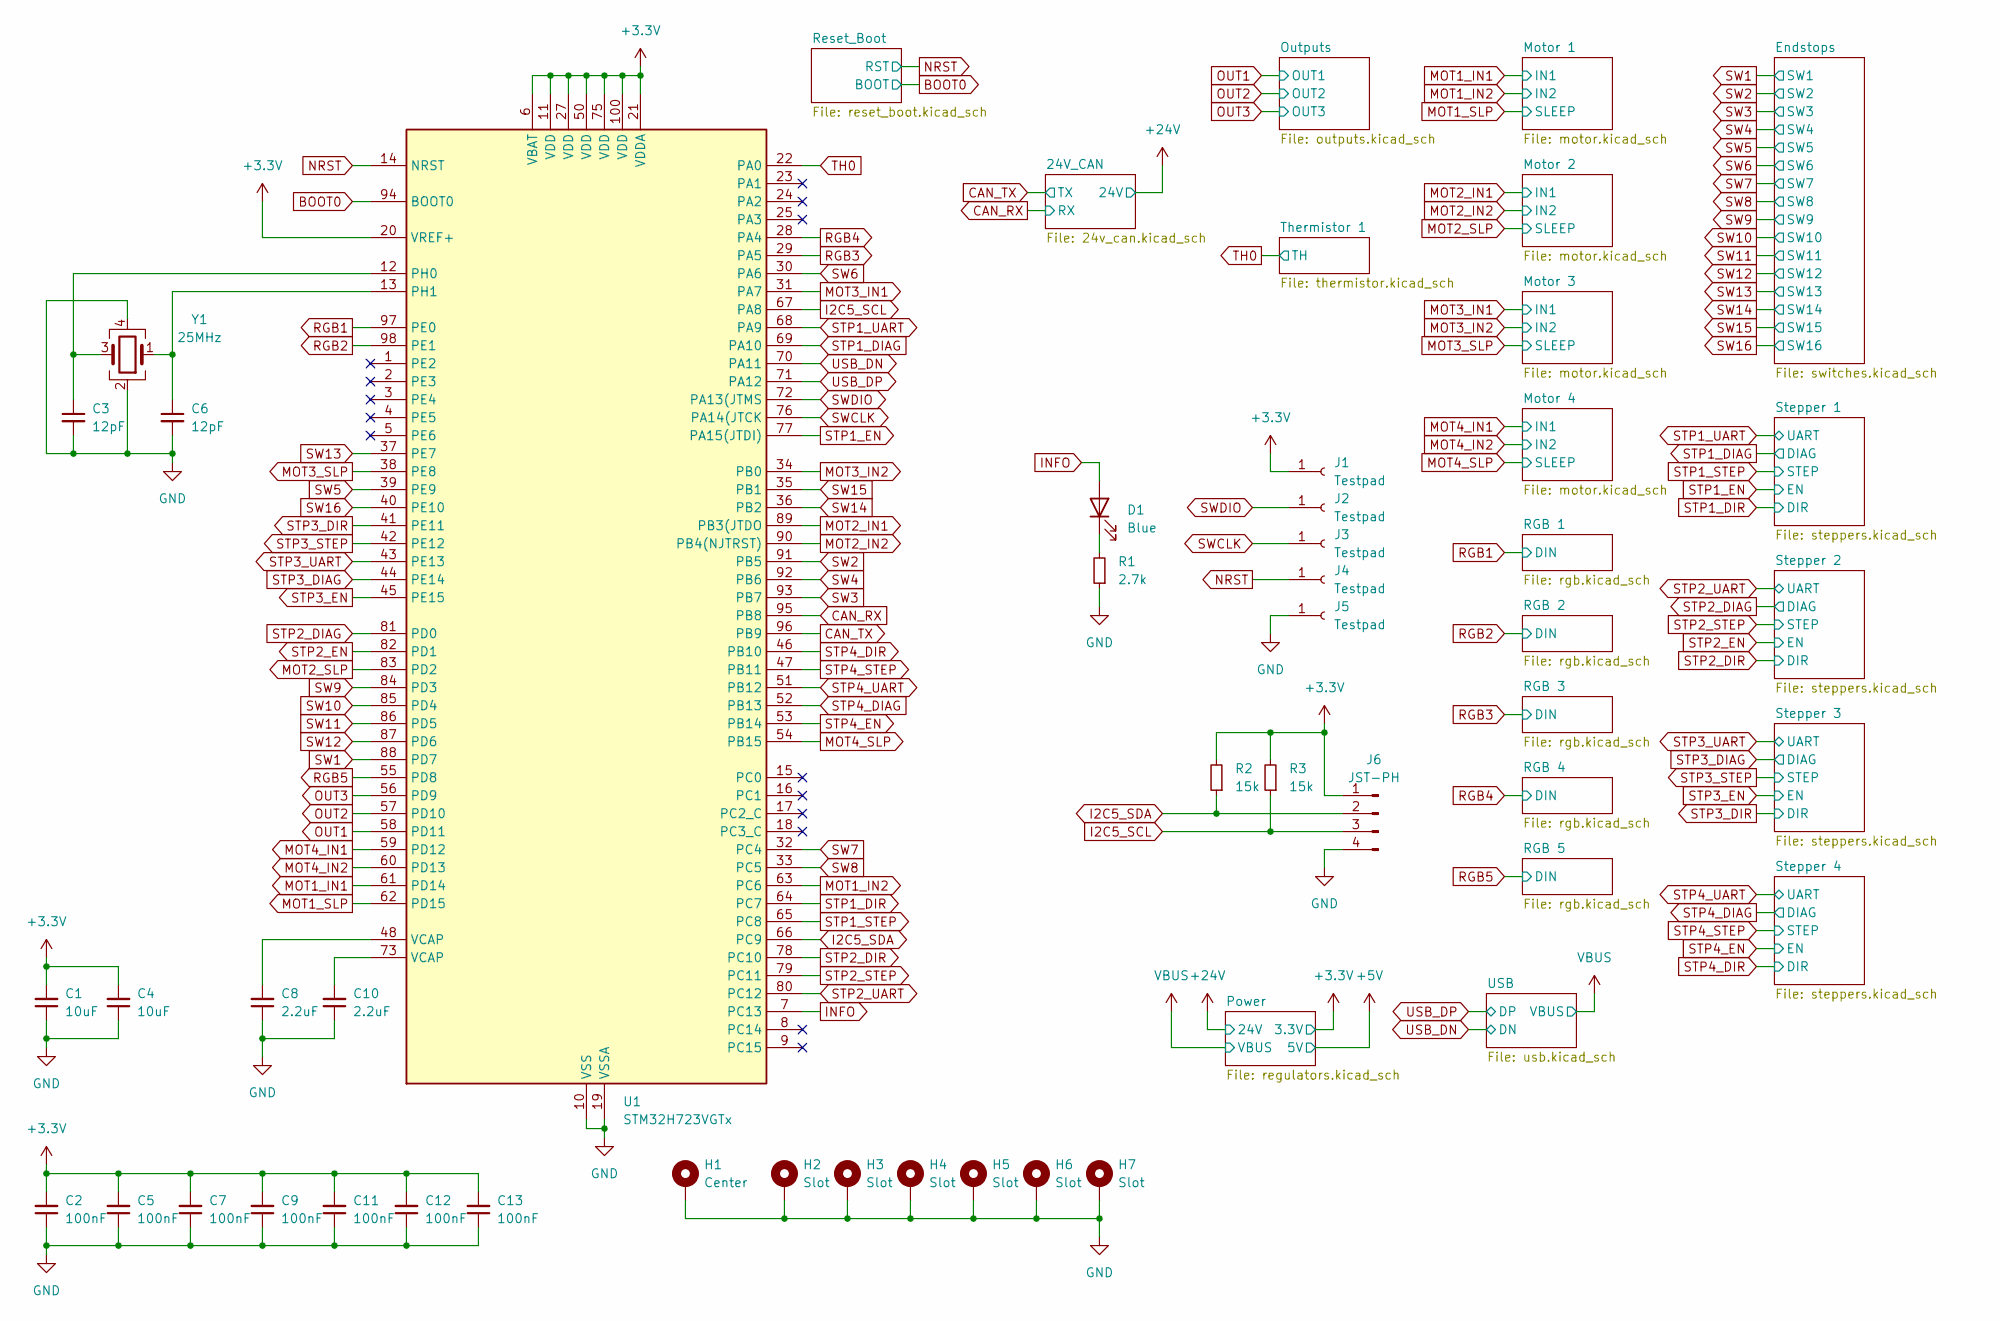
[picture p43: schematic longboi.kicad_sch]

Parts:
C1, C4: 10uF; C_0603_1608Metric; LCSC C19702
C2, C5, C7, C9, C11, C12, C13: 100nF; C_0603_1608Metric; LCSC C14663
C3, C6: 12pF; C_0603_1608Metric; LCSC C1644
C8, C10: 2.2uF; C_0603_1608Metric; LCSC C23630
D1: Blue; LED_0603_1608Metric; LCSC C965807
H1: Center; MountingHole_3.2mm_M3_ISO7380_Pad
H2, H3, H4, H5, H6, H7: Slot; MountingSlot3.2mm
J1, J2, J3, J4, J5: Testpad; TestPoint_THTPad_D1.0mm_Drill0.5mm
J6: JST-PH; JST_PH_B4B-PH-K_1x04_P2.00mm_Vertical; LCSC C5305780
R1: 2.7k; R_0603_1608Metric; LCSC C13167
R2, R3: 15k; R_0603_1608Metric; LCSC C22809
U1: STM32H723VGTx; LQFP-100_14x14mm_P0.5mm; LCSC C730142
Y1: 25MHz; Crystal_SMD_3225-4Pin_3.2x2.5mm; LCSC C9006

Connections:
+3.3V: C1.2, C2.2, C4.2, C5.2, C7.2, C9.2, C11.2, C12.2, C13.2, J1.1, J6.1, R2.2, R3.2, U1.6 (VBAT), U1.11 (VDD), U1.20 (VREF+), U1.21 (VDDA), U1.27 (VDD), U1.50 (VDD), U1.75 (VDD), U1.100 (VDD)
BOOT0: U1.94 (BOOT0)
CAN_RX: U1.95 (PB8)
CAN_TX: U1.96 (PB9)
GND: C1.1, C2.1, C3.2, C4.1, C5.1, C6.2, C7.1, C8.1, C9.1, C10.1, C11.1, C12.1, C13.1, H1.1, H2.1, H3.1, H4.1, H5.1, H6.1, H7.1, J5.1, J6.4, R1.1, U1.10 (VSS), U1.19 (VSSA), U1.26 (VSS), U1.49 (VSS), U1.74 (VSS), U1.99 (VSS), Y1.2, Y1.4
I2C5_SCL: J6.3, R3.1, U1.67 (PA8)
I2C5_SDA: J6.2, R2.1, U1.66 (PC9)
INFO: D1.2 (A), U1.7 (PC13)
MOT1_IN1: U1.61 (PD14)
MOT1_IN2: U1.63 (PC6)
MOT1_SLP: U1.62 (PD15)
MOT2_IN1: U1.89 (PB3(JTDO)
MOT2_IN2: U1.90 (PB4(NJTRST))
MOT2_SLP: U1.83 (PD2)
MOT3_IN1: U1.31 (PA7)
MOT3_IN2: U1.34 (PB0)
MOT3_SLP: U1.38 (PE8)
MOT4_IN1: U1.59 (PD12)
MOT4_IN2: U1.60 (PD13)
MOT4_SLP: U1.54 (PB15)
NRST: J4.1, U1.14 (NRST)
unnamed: C3.1, U1.12 (PH0), Y1.3
unnamed: C6.1, U1.13 (PH1), Y1.1
unnamed: C8.2, U1.48 (VCAP)
unnamed: C10.2, U1.73 (VCAP)
unnamed: D1.1 (K), R1.2
OUT1: U1.58 (PD11)
OUT2: U1.57 (PD10)
OUT3: U1.56 (PD9)
RGB1: U1.97 (PE0)
RGB2: U1.98 (PE1)
RGB3: U1.29 (PA5)
RGB4: U1.28 (PA4)
RGB5: U1.55 (PD8)
STP1_DIAG: U1.69 (PA10)
STP1_DIR: U1.64 (PC7)
STP1_EN: U1.77 (PA15(JTDI))
STP1_STEP: U1.65 (PC8)
STP1_UART: U1.68 (PA9)
STP2_DIAG: U1.81 (PD0)
STP2_DIR: U1.78 (PC10)
STP2_EN: U1.82 (PD1)
STP2_STEP: U1.79 (PC11)
STP2_UART: U1.80 (PC12)
STP3_DIAG: U1.44 (PE14)
STP3_DIR: U1.41 (PE11)
STP3_EN: U1.45 (PE15)
STP3_STEP: U1.42 (PE12)
STP3_UART: U1.43 (PE13)
STP4_DIAG: U1.52 (PB13)
STP4_DIR: U1.46 (PB10)
STP4_EN: U1.53 (PB14)
STP4_STEP: U1.47 (PB11)
STP4_UART: U1.51 (PB12)
SW1: U1.88 (PD7)
SW2: U1.91 (PB5)
SW3: U1.93 (PB7)
SW4: U1.92 (PB6)
SW5: U1.39 (PE9)
SW6: U1.30 (PA6)
SW7: U1.32 (PC4)
SW8: U1.33 (PC5)
SW9: U1.84 (PD3)
SW10: U1.85 (PD4)
SW11: U1.86 (PD5)
SW12: U1.87 (PD6)
SW13: U1.37 (PE7)
SW14: U1.36 (PB2)
SW15: U1.35 (PB1)
SW16: U1.40 (PE10)
SWCLK: J3.1, U1.76 (PA14(JTCK)
SWDIO: J2.1, U1.72 (PA13(JTMS)
TH0: U1.22 (PA0)
USB_DN: U1.70 (PA11)
USB_DP: U1.71 (PA12)
