Kr3jzolPL/longboi/pcb/lp.kicad_sch

## KiCad design pcb/lp.kicad_sch (2026-05-06)

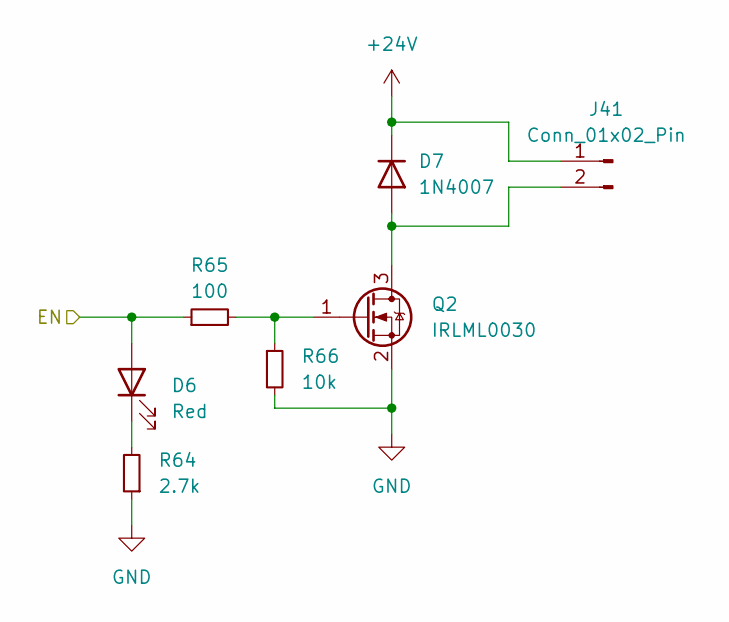
[picture p44: schematic lp.kicad_sch]

Parts:
D6: Red; LED_0603_1608Metric; LCSC C965799
D7: 1N4007; D_SOD-123; LCSC C2902912
J41: Conn_01x02_Pin; JST_XH_B2B-XH-A_1x02_P2.50mm_Vertical; LCSC C378939
Q2: IRLML0030; SOT-23; LCSC C67272
R64: 2.7k; R_0603_1608Metric; LCSC C13167
R65: 100; R_0603_1608Metric; LCSC C105588
R66: 10k; R_0603_1608Metric; LCSC C98220

Connections:
+24V: D7.1 (K), J41.1
EN: D6.2 (A), R65.1
GND: Q2.2 (S), R64.1, R66.2
unnamed: D6.1 (K), R64.2
unnamed: D7.2 (A), J41.2, Q2.3 (D)
unnamed: Q2.1 (G), R65.2, R66.1
