Kr3jzolPL/longboi/pcb/motor.kicad_sch

## KiCad design pcb/motor.kicad_sch (2026-05-06)

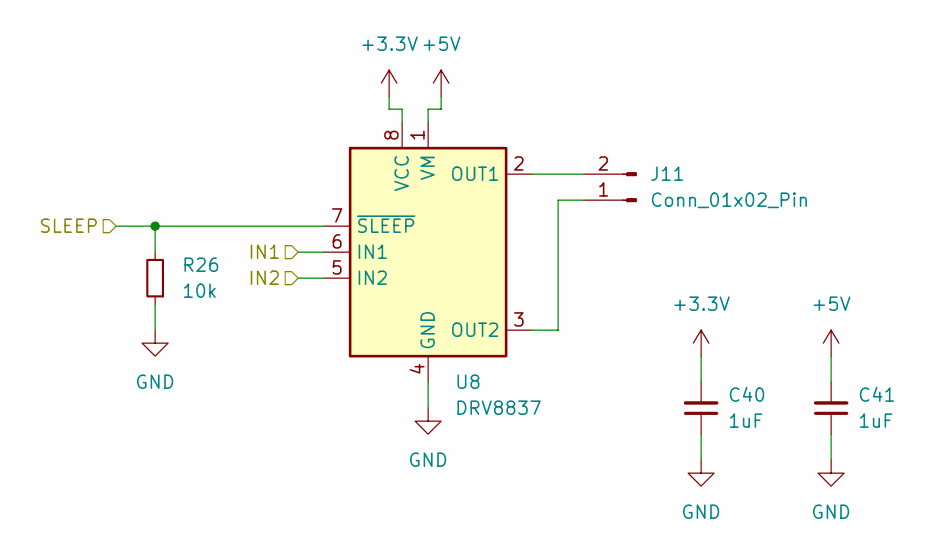
[picture p45: schematic motor.kicad_sch]

Parts:
C40, C41: 1uF; C_0603_1608Metric; LCSC C15849
J11: Conn_01x02_Pin; JST_XH_B2B-XH-A_1x02_P2.50mm_Vertical; LCSC C378939
R26: 10k; R_0603_1608Metric; LCSC C98220
U8: DRV8837; WSON-8-1EP_2x2mm_P0.5mm_EP0.9x1.6mm; LCSC C39159

Connections:
+3.3V: C40.2, U8.8 (VCC)
+5V: C41.2, U8.1 (VM)
GND: C40.1, C41.1, R26.1, U8.4 (GND), U8.9 (GND)
IN1: U8.6 (IN1)
IN2: U8.5 (IN2)
unnamed: J11.1, U8.3 (OUT2)
unnamed: J11.2, U8.2 (OUT1)
SLEEP: R26.2, U8.7 (~SLEEP)
