Kr3jzolPL/longboi/pcb/outputs.kicad_sch

## KiCad design pcb/outputs.kicad_sch (2026-05-06)

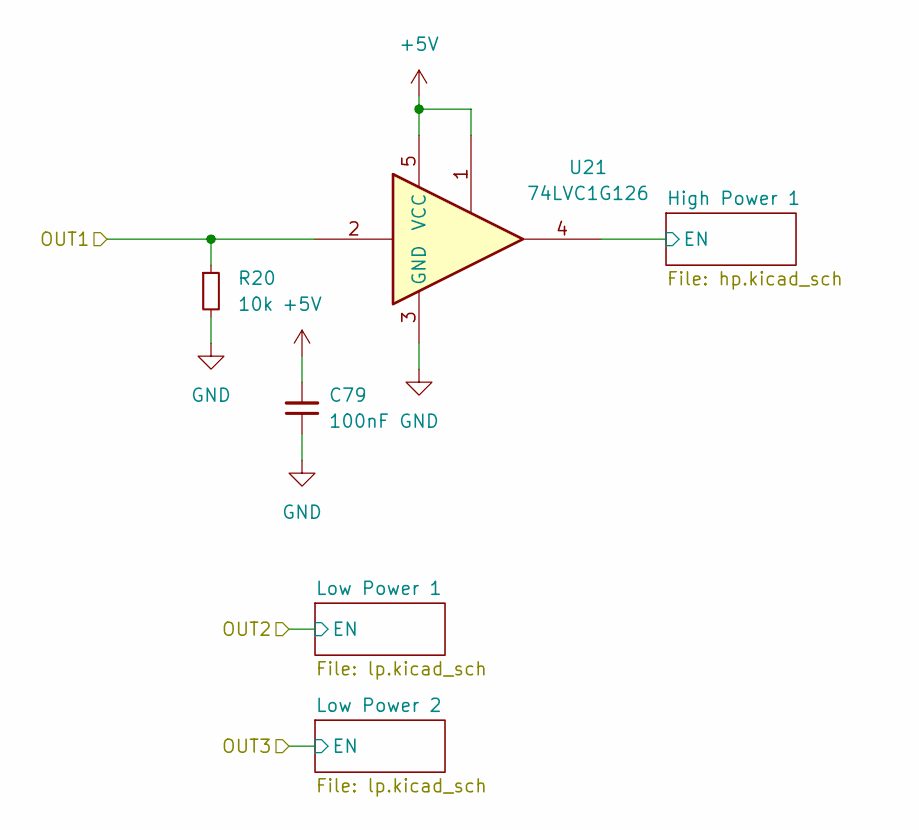
[picture p46: schematic outputs.kicad_sch]

Parts:
C79: 100nF; C_0603_1608Metric; LCSC C14663
R20: 10k; R_0603_1608Metric; LCSC C98220
U21: 74LVC1G126; SOT-353_SC-70-5; LCSC C7394032

Connections:
+5V: C79.2, U21.1, U21.5 (VCC)
EN: U21.4
GND: C79.1, R20.2, U21.3 (GND)
OUT1: R20.1, U21.2
