Kr3jzolPL/longboi/pcb/regulators.kicad_sch

## KiCad design pcb/regulators.kicad_sch (2026-05-06)

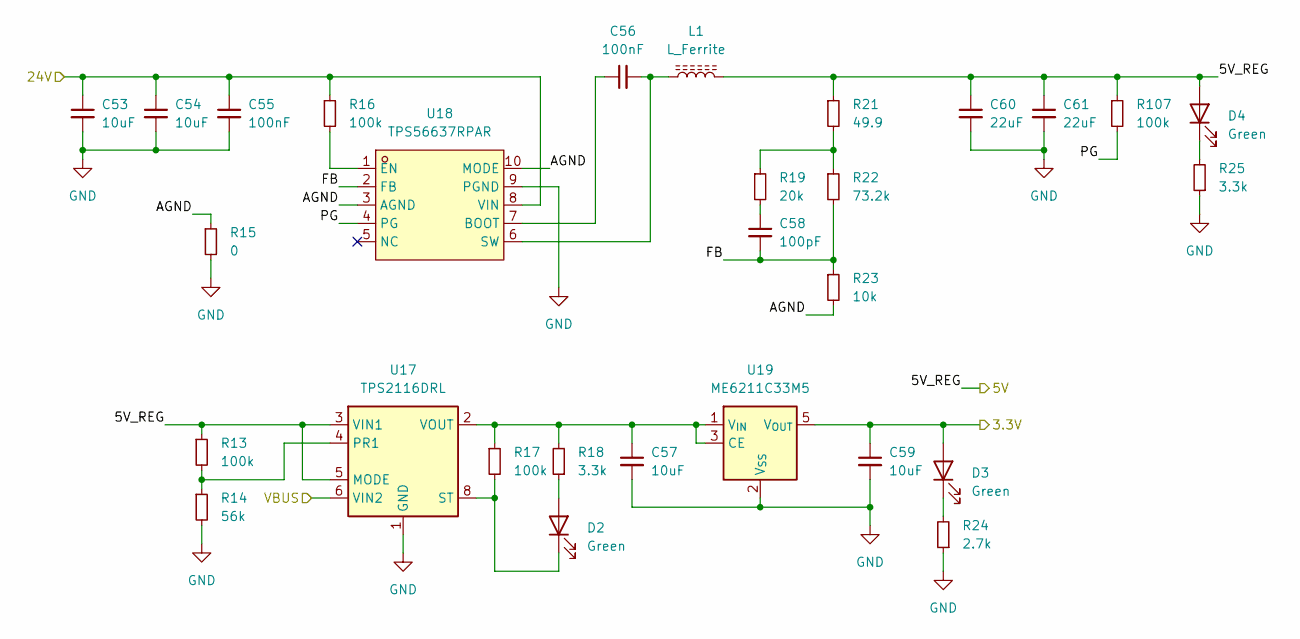
[picture p47: schematic regulators.kicad_sch]

Parts:
C53, C54: 10uF; C_1206_3216Metric; LCSC C13585
C55, C56: 100nF; C_0603_1608Metric; LCSC C14663
C57, C59: 10uF; C_0603_1608Metric; LCSC C19702
C58: 100pF; C_0603_1608Metric; LCSC C14665
C60, C61: 22uF; C_0805_2012Metric; LCSC C602037
D2, D3, D4: Green; LED_0603_1608Metric; LCSC C2994781
L1: L_Ferrite; L_Chilisin_BMRA00050530; LCSC C7187309
R13, R16, R17, R107: 100k; R_0603_1608Metric; LCSC C14675
R14: 56k; R_0603_1608Metric; LCSC C23206
R15: 0; R_0603_1608Metric; LCSC C95177
R18, R25: 3.3k; R_0603_1608Metric; LCSC C22978
R19: 20k; R_0603_1608Metric; LCSC C2907011
R21: 49.9; R_0603_1608Metric; LCSC C114625
R22: 73.2k; R_0603_1608Metric; LCSC C14890
R23: 10k; R_0603_1608Metric; LCSC C98220
R24: 2.7k; R_0603_1608Metric; LCSC C13167
U17: TPS2116DRL; SOT-583-8; LCSC C3235557
U18: TPS56637RPAR; VQFN-HR-10_L3.0-W3.0_RPA; LCSC Part C841386
U19: ME6211C33M5; SOT-23-5; LCSC C82942

Connections:
3.3V: C59.1, D3.2 (A), U19.5 (V_{OUT})
5V: C60.1, C61.1, D4.2 (A), L1.2, R13.1, R21.1, R107.1, U17.3 (VIN1), U17.5 (MODE)
24V: C53.1, C54.1, C55.1, R16.1, U18.8 (VIN)
AGND: R15.1, R23.2, U18.3 (AGND), U18.10 (MODE)
FB: C58.2, R22.2, R23.1, U18.2 (FB)
GND: C53.2, C54.2, C55.2, C57.2, C59.2, C60.2, C61.2, R14.2, R15.2, R24.1, R25.1, U17.1 (GND), U18.9 (PGND), U19.2 (V_{SS})
unnamed: C56.1, U18.7 (BOOT)
unnamed: C56.2, L1.1, U18.6 (SW)
unnamed: C57.1, R17.1, R18.2, U17.2 (VOUT), U17.7 (VOUT), U19.1 (V_{IN}), U19.3 (CE)
unnamed: C58.1, R19.2
unnamed: D2.1 (K), R17.2, U17.8 (ST)
unnamed: D2.2 (A), R18.1
unnamed: D3.1 (K), R24.2
unnamed: D4.1 (K), R25.2
unnamed: R13.2, R14.1, U17.4 (PR1)
unnamed: R16.2, U18.1 (EN)
unnamed: R19.1, R21.2, R22.1
PG: R107.2, U18.4 (PG)
VBUS: U17.6 (VIN2)
