Kr3jzolPL/longboi/pcb/reset_boot.kicad_sch

## KiCad design pcb/reset_boot.kicad_sch (2026-05-06)

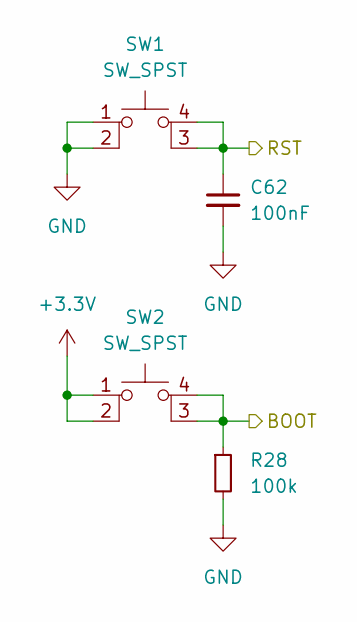
[picture p48: schematic reset_boot.kicad_sch]

Parts:
C62: 100nF; C_0603_1608Metric; LCSC C14663
R28: 100k; R_0603_1608Metric; LCSC C14675
SW1, SW2: SW_SPST; SW-SMD_4P-L3.4-W3.4-P2.00-LS4.0_TS3315A160GF; LCSC C557593

Connections:
+3.3V: SW2.1, SW2.2
BOOT: R28.1, SW2.3 (K), SW2.4 (A)
GND: C62.2, R28.2, SW1.1, SW1.2
RST: C62.1, SW1.3 (K), SW1.4 (A)
