Kr3jzolPL/longboi/pcb/rgb.kicad_sch

## KiCad design pcb/rgb.kicad_sch (2026-05-06)

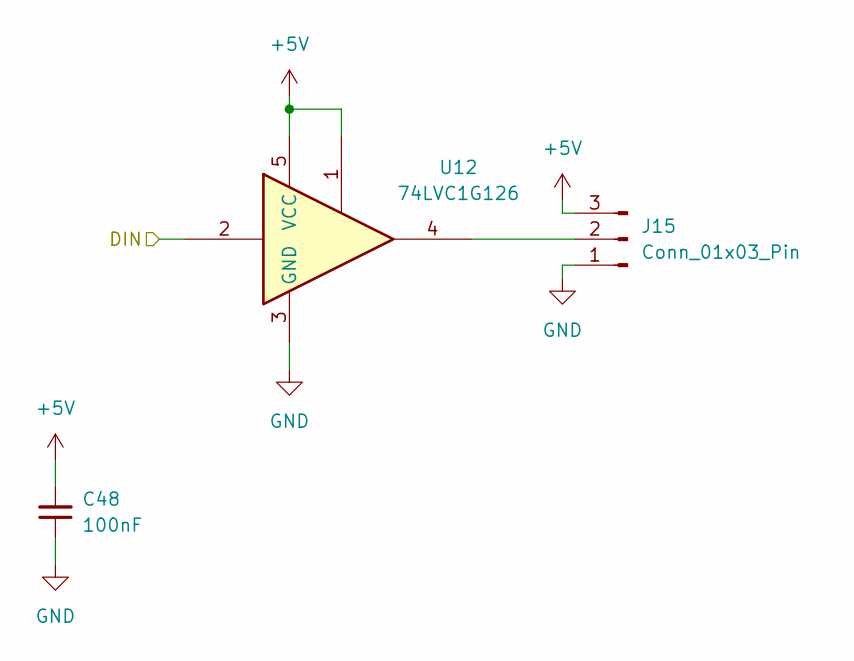
[picture p49: schematic rgb.kicad_sch]

Parts:
C48: 100nF; C_0603_1608Metric; LCSC C14663
J15: Conn_01x03_Pin; JST_XH_B3B-XH-A_1x03_P2.50mm_Vertical; LCSC C565985
U12: 74LVC1G126; SOT-353_SC-70-5; LCSC C7394032

Connections:
+5V: C48.2, J15.3, U12.1, U12.5 (VCC)
DIN: U12.2
GND: C48.1, J15.1, U12.3 (GND)
unnamed: J15.2, U12.4
