Kr3jzolPL/longboi/pcb/steppers.kicad_sch

## KiCad design pcb/steppers.kicad_sch (2026-05-06)

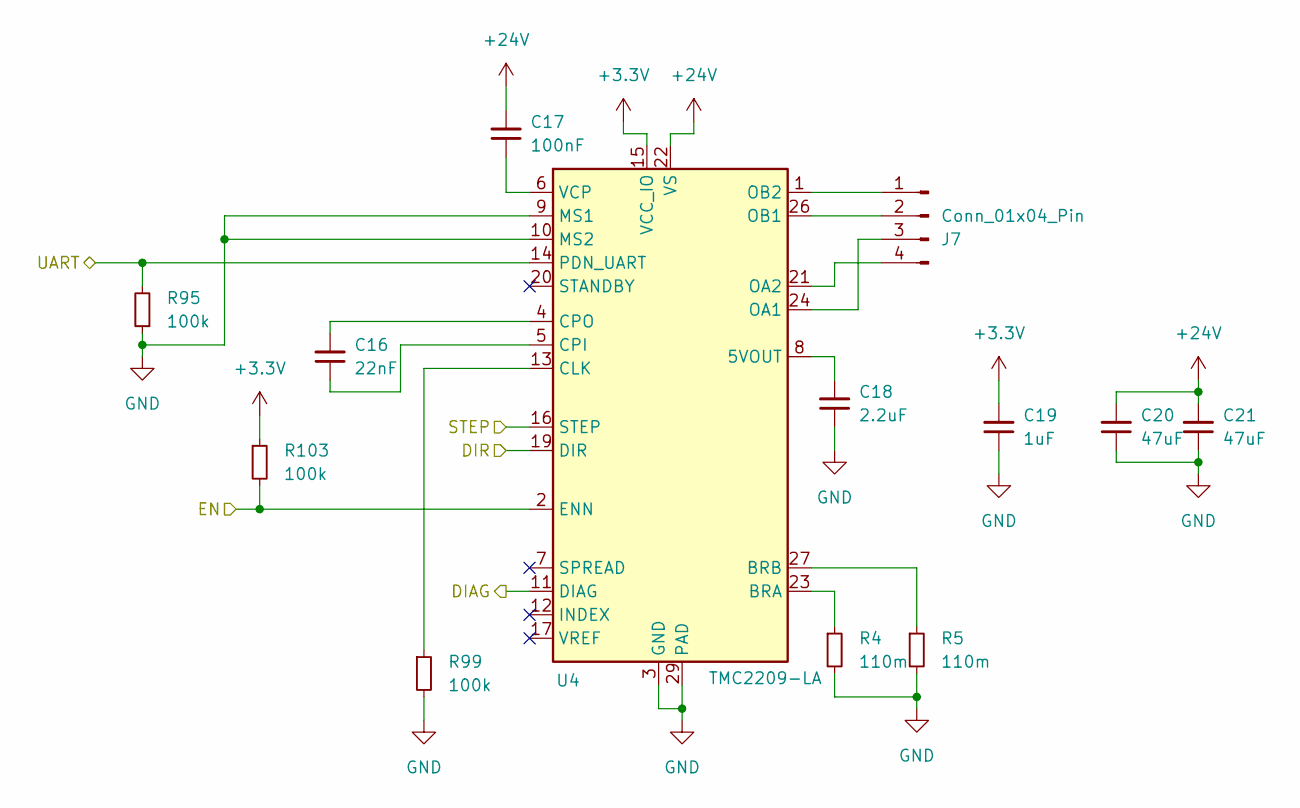
[picture p50: schematic steppers.kicad_sch]

Parts:
C16: 22nF; C_0603_1608Metric; LCSC C21122
C17: 100nF; C_0603_1608Metric; LCSC C14663
C18: 2.2uF; C_0603_1608Metric; LCSC C23630
C19: 1uF; C_0603_1608Metric; LCSC C15849
C20, C21: 47uF; C_1210_3225Metric; LCSC C6120020
J7: Conn_01x04_Pin; JST_XH_B4B-XH-A_1x04_P2.50mm_Vertical; LCSC C566013
R4, R5: 110m; R_1206_3216Metric; LCSC C2934288
R95, R99, R103: 100k; R_0603_1608Metric; LCSC C14675
U4: TMC2209-LA; QFN-28-1EP_5x5mm_P0.5mm_EP3.75x3.75mm_ThermalVias; LCSC C2150710

Connections:
+3.3V: C19.2, R103.1, U4.15 (VCC_IO)
+24V: C17.2, C20.2, C21.2, U4.22 (VS), U4.28 (VS)
DIAG: U4.11 (DIAG)
DIR: U4.19 (DIR)
EN: R103.2, U4.2 (ENN)
GND: C18.1, C19.1, C20.1, C21.1, R4.2, R5.2, R95.1, R99.2, U4.3 (GND), U4.9 (MS1), U4.10 (MS2), U4.18 (GND), U4.29 (PAD)
unnamed: C16.1, U4.5 (CPI)
unnamed: C16.2, U4.4 (CPO)
unnamed: C17.1, U4.6 (VCP)
unnamed: C18.2, U4.8 (5VOUT)
unnamed: J7.1, U4.1 (OB2)
unnamed: J7.2, U4.26 (OB1)
unnamed: J7.3, U4.24 (OA1)
unnamed: J7.4, U4.21 (OA2)
unnamed: R4.1, U4.23 (BRA)
unnamed: R5.1, U4.27 (BRB)
unnamed: R99.1, U4.13 (CLK)
STEP: U4.16 (STEP)
UART: R95.2, U4.14 (PDN_UART)
