Kr3jzolPL/longboi/pcb/switch.kicad_sch

## KiCad design pcb/switch.kicad_sch (2026-05-06)

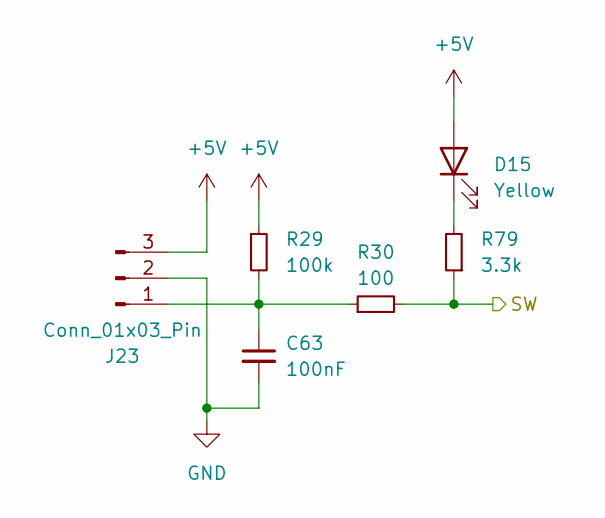
[picture p51: schematic switch.kicad_sch]

Parts:
C63: 100nF; C_0603_1608Metric; LCSC C14663
D15: Yellow; LED_0603_1608Metric; LCSC C72038
J23: Conn_01x03_Pin; JST_XH_B3B-XH-A_1x03_P2.50mm_Vertical; LCSC C565985
R29: 100k; R_0603_1608Metric; LCSC C14675
R30: 100; R_0603_1608Metric; LCSC C105588
R79: 3.3k; R_0603_1608Metric; LCSC C22978

Connections:
+5V: D15.2 (A), J23.3, R29.1
GND: C63.2, J23.2
unnamed: C63.1, J23.1, R29.2, R30.1
unnamed: D15.1 (K), R79.2
SW: R30.2, R79.1
