Kr3jzolPL/longboi/pcb/switches.kicad_sch

## KiCad design pcb/switches.kicad_sch (2026-05-06)

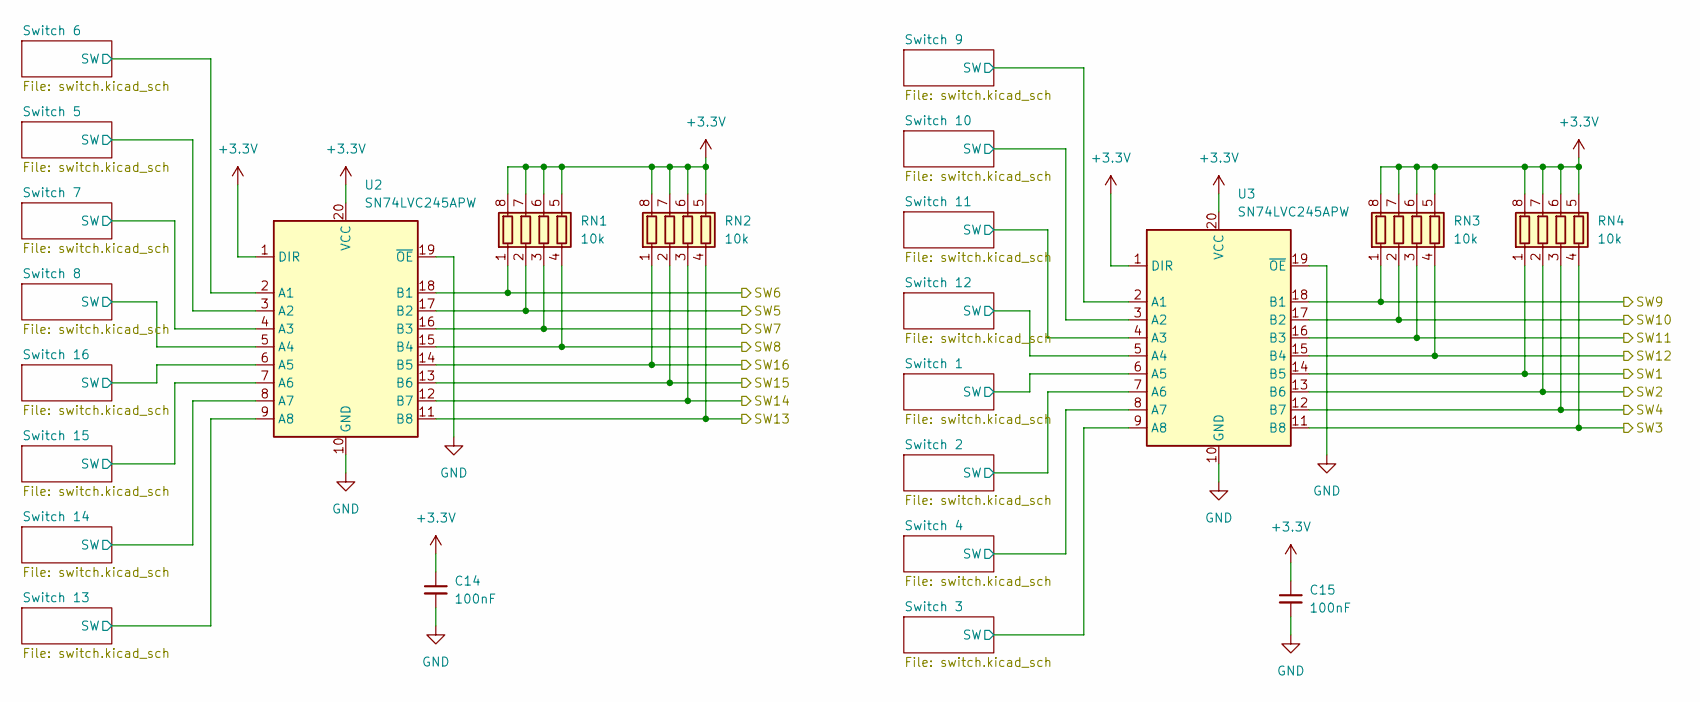
[picture p52: schematic switches.kicad_sch]

Parts:
C14, C15: 100nF; C_0603_1608Metric; LCSC C14663
RN1, RN2, RN3, RN4: 10k; R_Array_Convex_4x0603; LCSC C29718
U2, U3: SN74LVC245APW; TSSOP-20_4.4x6.5mm_P0.65mm; LCSC C7848

Connections:
+3.3V: C14.1, C15.1, RN1.5 (R4.2), RN1.6 (R3.2), RN1.7 (R2.2), RN1.8 (R1.2), RN2.5 (R4.2), RN2.6 (R3.2), RN2.7 (R2.2), RN2.8 (R1.2), RN3.5 (R4.2), RN3.6 (R3.2), RN3.7 (R2.2), RN3.8 (R1.2), RN4.5 (R4.2), RN4.6 (R3.2), RN4.7 (R2.2), RN4.8 (R1.2), U2.1 (DIR), U2.20 (VCC), U3.1 (DIR), U3.20 (VCC)
GND: C14.2, C15.2, U2.10 (GND), U2.19 (~OE), U3.10 (GND), U3.19 (~OE)
SW: U2.2 (A1), U2.3 (A2), U2.4 (A3), U2.5 (A4), U2.6 (A5), U2.7 (A6), U2.8 (A7), U2.9 (A8), U3.2 (A1), U3.3 (A2), U3.4 (A3), U3.5 (A4), U3.6 (A5), U3.7 (A6), U3.8 (A7), U3.9 (A8)
SW1: RN4.1 (R1.1), U3.14 (B5)
SW2: RN4.2 (R2.1), U3.13 (B6)
SW3: RN4.4 (R4.1), U3.11 (B8)
SW4: RN4.3 (R3.1), U3.12 (B7)
SW5: RN1.2 (R2.1), U2.17 (B2)
SW6: RN1.1 (R1.1), U2.18 (B1)
SW7: RN1.3 (R3.1), U2.16 (B3)
SW8: RN1.4 (R4.1), U2.15 (B4)
SW9: RN3.1 (R1.1), U3.18 (B1)
SW10: RN3.2 (R2.1), U3.17 (B2)
SW11: RN3.3 (R3.1), U3.16 (B3)
SW12: RN3.4 (R4.1), U3.15 (B4)
SW13: RN2.4 (R4.1), U2.11 (B8)
SW14: RN2.3 (R3.1), U2.12 (B7)
SW15: RN2.2 (R2.1), U2.13 (B6)
SW16: RN2.1 (R1.1), U2.14 (B5)
