Kr3jzolPL/longboi/pcb/thermistor.kicad_sch

## KiCad design pcb/thermistor.kicad_sch (2026-05-06)

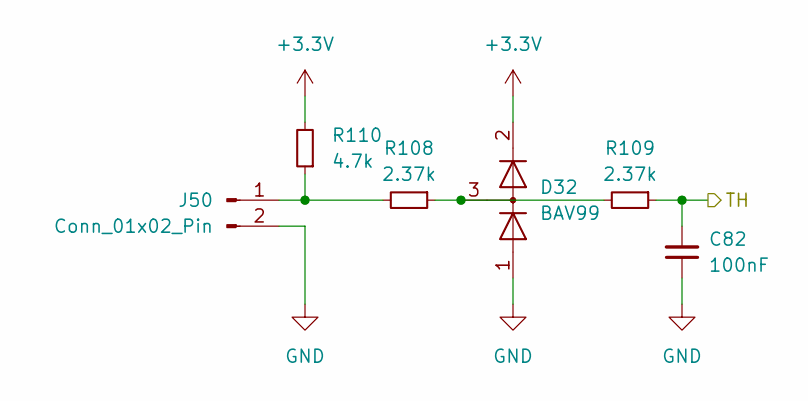
[picture p53: schematic thermistor.kicad_sch]

Parts:
C82: 100nF; C_0603_1608Metric; LCSC C14663
D32: BAV99; SOT-23; LCSC C2500
J50: Conn_01x02_Pin; JST_XH_B2B-XH-A_1x02_P2.50mm_Vertical; LCSC C378939
R108, R109: 2.37k; C_0603_1608Metric; LCSC C705759
R110: 4.7k; C_0603_1608Metric; LCSC C99782

Connections:
+3.3V: D32.2 (A), R110.2
GND: C82.1, D32.1 (K), J50.2
unnamed: D32.3 (K), R108.1, R109.2
unnamed: J50.1, R108.2, R110.1
TH: C82.2, R109.1
