Kr3jzolPL/longboi/pcb/usb.kicad_sch

## KiCad design pcb/usb.kicad_sch (2026-05-06)

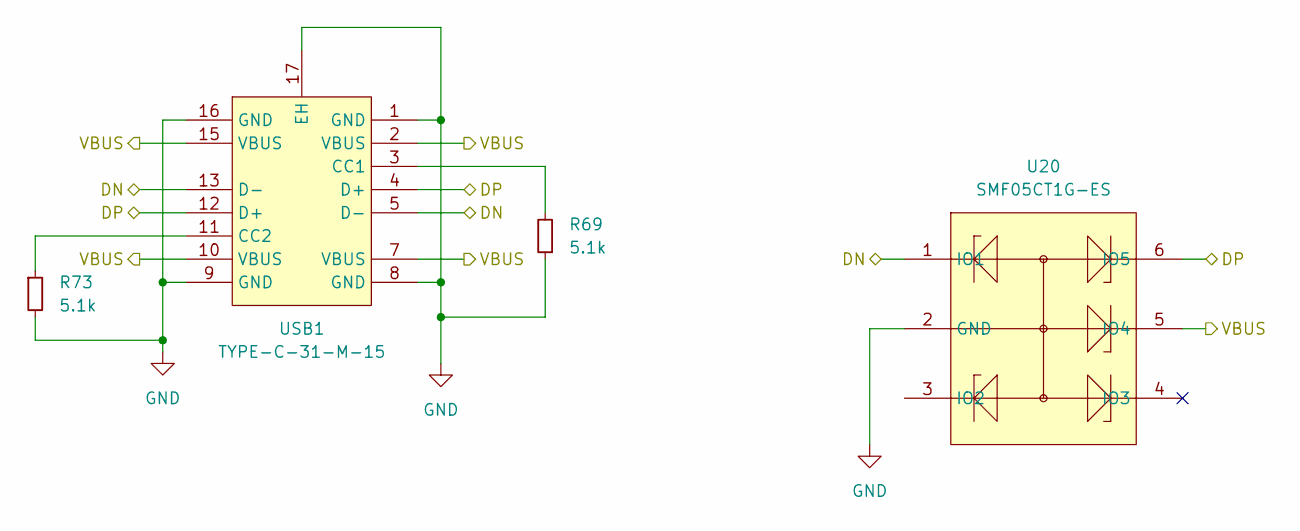
[picture p54: schematic usb.kicad_sch]

Parts:
R69, R73: 5.1k; R_0603_1608Metric; LCSC C23186
U20: SMF05CT1G-ES; SOT-363_SC-70-6; LCSC Part C5180312
USB1: TYPE-C-31-M-15; USBC-TH_TYPE-C-31-M-15; LCSC Part C223908

Connections:
DN: U20.1 (IO1), USB1.5 (D-), USB1.13 (D-)
DP: U20.6 (IO5), USB1.4 (D+), USB1.12 (D+)
GND: R69.1, R73.2, U20.2 (GND), USB1.1 (GND), USB1.8 (GND), USB1.9 (GND), USB1.16 (GND), USB1.17 (EH)
unnamed: R69.2, USB1.3 (CC1)
unnamed: R73.1, USB1.11 (CC2)
VBUS: U20.5 (IO4), USB1.2 (VBUS), USB1.7 (VBUS), USB1.10 (VBUS), USB1.15 (VBUS)
