Kr3jzolPL/longboi/(commit log)

2026-01-31 change usb-c to tht type
    [bom.csv, designators.csv, usb.kicad_sch]
2026-02-02 fixes #18 fixes #26
    replace usb-c connector
    [24v_can.kicad_sch, bom.csv, designators.csv, longboi.kicad_sch, positions.csv, switches.kicad_sch, usb.kicad_sch]
2026-03-24 removed erroneous production files
    [bom.csv, positions.csv]
2026-05-06 update kicad gitignore add schematics pdf plot
2026-05-06 update sheets to KiCAD 10
    [24v_can.kicad_sch, hp.kicad_sch, longboi.kicad_sch, lp.kicad_sch, motor.kicad_sch, outputs.kicad_sch, regulators.kicad_sch, reset_boot.kicad_sch]
